Rb-Cs-lab/coil-servo/docs/register_map.md

# Register map (implemented in `cores/coil_servo_top.v`)

Single source of truth for CFG/STS field layout.
`model/coil_servo_model/registers.py` mirrors this file (the integration
testbench and the host tools both use it); the HDL slices in
`coil_servo_top.v` follow this table. **Never invent offsets — change this
file first**, then registers.py, then the HDL (the integration bench catches
disagreement between the last two).

Number formats (`s14`, `Q1.13`, "counts", two's complement) are defined in
the "How to read this document" paragraph of [design.md](design.md).
"Board frame" = signed values as physically measured at the connectors;
"drive frame" = after multiplying by the bridge polarity sign so the loop
always sees positive plant gain (design.md Node B).

## Addressing

One `axi_hub` block connects the FPGA registers to the board's Linux
(and, through the on-board server, to Python on the lab PC) at physical
address **0x4000_0000**. Address bits [27:24] select the hub port; bits
[23:2] select a 32-bit word within it.

| Port | Base | Contents |
|---|---|---|
| 0 | 0x4000_0000 | CFG — the servo's settings, one parameter per 32-bit word (readable back; the host also keeps a local copy) |
| 1 | 0x4100_0000 | STS — live status, read-only |
| 2 | 0x4200_0000 | capture FIFO — **each read pops one word destructively**; drain it only via `Board.capture()` |
| 4 | 0x4400_0000 | XADC readout (the Zynq chip's built-in slow ADC that digitizes the E2 pins: AIN0 coil temperature, AIN1 rail voltage). No host tool reads this yet; code→physical calibration TBD |

One word per parameter (CFG_DATA_WIDTH = 1024, i.e. 32 words — raised
from 512 in MVP rewrite step 3 when words 16–19 were added;
STS_DATA_WIDTH = 256):
wasteful of hub width, trivial to read in a debugger, immune to
straddled-field read/write tearing. All multi-bit fields LSB-aligned in
their word; unused high bits read/write as 0.

## CFG (0x4000_0000 + 4·word)

| Word | Name | Format | Reset | Meaning |
|---|---|---|---|---|
| 0 | `ctrl` | bits | 0 | b0 `servo_enable` (1→0 triggers a graceful ramp-to-zero stop, never an instant bridge drop); b1 `int_clear` (level; pulse from host); b2 `sp_source` (0 = IN2 analog, 1 = `setpoint` reg); b3 `fifo_rst`; b4 `out2_invert`; b5 `boost_mode` (0 = manual, 1 = auto); b6 `boost_manual`; b7 `flip_fault_ack`; b15:8 `led`; b16 `open_loop` (setpoint drives the output stage directly for hardware-in-the-loop ("HIL") transfer-function measurement — clamp/mux/bridge gating still apply; since rev 4 the PI integrator is held cleared while it is set, so switching back to closed loop never applies a wound-up integrator); b17 `capture_sel` (FIFO source: 0 = raw ADC @ 125 MS/s, 131 µs window; 1 = decimated `{error[21:6], measured[21:6]}` per PI tick, 16.8 ms window); b18 `out2_enable` (0 = OUT2 held at exactly 0 V whatever the PI asks for — the MVP has no active clamp; 1 = full-architecture OUT1/OUT2 handoff. Also selects the PI's lower bound: 0 → the floor of word 16, 1 → −`out_clamp`); b19 `trip_ack` (level; pulse from host: leaves TRIPPED for IDLE — re-arming then needs a fresh DIO4 edge); b20 `dither_enable` (1 = OUT1 sigma-delta dither in closed loop: the DAC toggles ±1 count every clock so its average carries the 7 bits of PI output that rounding would drop — ~0.12 A → ~1 mA effective step on the MOT; never exceeds `out_clamp`; MOT: 1. Reset 0 = off); b21 `snap_enable` (rev 5, **zero-setpoint snap**: in RUN, closed loop, when the selected setpoint averaged over one PI tick is within `snap_thresh` (word 23) of zero, OUT1 is forced to exactly 0 at once and the PI integrator is held cleared, so the coil freewheels to zero at its natural rate (bridge stays closed) instead of the PI winding OUT1 down (bench 2026-11-12: ≈ 1.3 ms tail at 2 A). When the setpoint leaves zero the integrator restarts from the RUN floor, exactly like a step from rest. **Also during the board's own forced zero** (build 2026-11-13 onwards, same bit): while the FSM brings the setpoint to zero itself for a flip or a stop (ramp-down, dead time, settle, timeout hold) with the bridge closed, OUT1 is held at 0 the same way, so those ramp-downs run at the freewheel rate whatever the requested setpoint is (bench test 3e: without it a ~0.4 A plateau of 150-250 us remained when the flip request came before the setpoint sign change). Reset 0 = off: OUT1 follows the PI as in rev 4) |
| 1 | `setpoint` | s14 Q1.13 | 0 | register setpoint (counts of I_FS) |
| 2 | `kp_mant` | s18 | 0 | P gain mantissa |
| 3 | `kp_shift` | u5 | 0 | P gain right-shift |
| 4 | `ki_mant` | s18 | 0 | I gain mantissa (per-tick) |
| 5 | `ki_shift` | u6 | 0 | I accumulator right-shift |
| 6 | `out_clamp` | u14 Q1.13 | 0 | hard output clamp, counts — an upper bound on the OUT1 *command* (MVP: calibrate from the measured G_pass; it is not by itself a current limit — word 17 is). Reset 0 ⇒ outputs forced 0 until configured — safe. The host `Board` class additionally refuses to write a value above rated unless constructed with `max_clamp=None` (a typo rail; the fabric clamp is the real enforcement). |
| 7 | `deadband` | u14 Q1.13 | 0 | OUT1/OUT2 handoff deadband |
| 8 | `zero_win` | u14 Q1.13 | 0 | flip zero-current window (counts) — PROVISIONAL. Also the setpoint snap window of the slew limiter (word 20) |
| 9 | `zero_holdoff` | u16 | 0 | decimated samples the window must hold |
| 10 | `deadtime` | u16 | 125 | bridge dead time, 8 ns ticks (125 = 1 µs) — PROVISIONAL |
| 11 | `settle` | u32 | 0 | post-flip settle, 8 ns ticks — eddy placeholder, PROVISIONAL |
| 12 | `flip_timeout` | u32 | 0 | RAMP_DOWN timeout, 8 ns ticks. 0 = disabled — but on a real coil always set it nonzero: it is the safety net that parks a flip that can't reach zero current in TIMEOUT_HOLD instead of waiting forever |
| 13 | `dio_invert` | bits | 0 | invert sense of E1 *inputs*: b0 flip request (DIO3), b1 arm (DIO4), b2 fault (DIO5). Reset 0 = as listed in the port table. Output polarities are fixed in HDL on purpose (reset state must be safe unconfigured). |
| 14 | — | u12 | 0 | reserved for `aout0_trim` (transducer offset trim via slow PWM output; wired up in session 7 when it can be validated against a voltmeter) |
| 15 | `slew_up` | u16 | 0 | setpoint slew-rate limit **away from zero** (\|setpoint\| growing), in 2<sup>−14</sup> counts per 8 ns clock (= 2<sup>−7</sup> counts per PI tick). MOT: 200 A/ms → **1074** at I_FS = 200 A (`slew_rate_code()` in fixed_point.py). Applies to IN2 and the `setpoint` register in closed loop; bypassed in `open_loop`; an FSM-forced zero (IDLE, ramp-down, flip, trip) drops the setpoint to 0 at once and it ramps up from 0 afterwards. Reset 0 = the setpoint cannot move (servo does nothing until configured — fail-safe). Why: large steps overshoot/undershoot on the MVP plant (mvp_architecture.md 3.1). |
| 16 | `u_floor` | u14 Q1.13 | 0 | PI lower bound **in RUN only** (MVP, `out2_enable` = 0): the PI output and integrator never go below this many OUT1 counts, so OUT1 rests just below the pass-bank dead zone instead of at 0. Set to ~90 % of the *measured* dead zone (mvp_architecture.md 3.1). Outside RUN the lower bound is 0. Must be < `out_clamp` (the clamp wins if not). Reset 0 = plain zero floor. |
| 17 | `trip_level` | u14 Q1.13 | 0 | over-current trip level, counts **of the IN1 sensor scale** (1 count = I_FS/8192, 24.4 mA at I_FS = 200 A). Trips when \|measured current\| > level for `trip_ticks` consecutive PI ticks, in every state except IDLE. Reset 0 = trips on the first nonzero reading — the servo cannot run until this is configured (fail-safe). MOT: 100 A. |
| 18 | `trip_ticks` | u16 | 0 | consecutive decimated samples (1.024 µs each) above `trip_level` before tripping; 0 and 1 both mean "first sample". |
| 19 | `trip_timeout` | u32 | 0 | after a trip, the longest the bridge stays closed (OUT1 = 0, coil freewheeling) waiting for the current to fall inside `zero_win`, in 8 ns ticks. Then the bridge opens regardless (e.g. a shorted pass FET keeps current flowing). 0 = open the bridge at once (pushes the coil energy into the supply; mvp_architecture.md 3.3). MOT: ~3 ms, comfortably above the 1.3 ms freewheel from 100 A. |
| 20 | `slew_down` | u16 | 0 | setpoint slew-rate limit **toward zero**, same units as word 15. MOT: 50 A/ms → **268**. A move across zero uses this rate down to 0, then `slew_up`. **Snap:** a target inside the zero window (\|target\| < `zero_win`, word 8) is taken at once, unlimited — so stepping the setpoint to zero is a full-speed snap-off (the coil freewheels, ~1.3 ms from 100 A); the down-limit exists to prevent undershoot, which cannot happen at a zero target (decided 2026-11-10). **Bench 2026-11-12:** in practice the PI winds OUT1 down rather than dropping it, so the current falls at the freewheel rate only down to a few tenths of an amp and then tails (2 A: 2 % only after ≈ 1.3 ms); rev 5 adds the zero-setpoint snap (ctrl b21, word 23), which removes it. |
| 21 | `in1_offset` | s14 Q1.13 | 0 | **IN1 zero offset**, counts: subtracted (saturating to s14) from every IN1 sample before the loop, the over-current trip, the zero window, STS `i_meas` and the decimated capture see it. Measure it with `python -m coil_servo_host.zero <channel>` (servo stopped, no current; it records the *raw* ADC codes) and store it as `in1_offset_amps` in channels.toml. **Characterise every new LEM / sensor chain** — a magnetised LEM read ≈ −5.8 A at zero on 11-11. Rev 4. |
| 22 | `in2_offset` | s14 Q1.13 | 0 | **IN2 zero offset** (the analog setpoint input), counts, subtracted the same way; measured by the same tool with the control computer's output at 0 V. Rev 4. |
| 23 | `snap_thresh` | u14 Q1.13 | 0 | zero-setpoint snap threshold (ctrl b21), counts of the setpoint scale: the snap engages when \|tick-averaged setpoint\| ≤ `snap_thresh` and releases when it exceeds `snap_thresh` + 1 (one count of hysteresis). 0 = only an exactly-zero setpoint (the `setpoint` register path); the analog IN2 path needs a few counts for its noise. Must stay well below `zero_win` — any setpoint inside it can no longer be held. The tick average (128 samples) keeps per-sample IN2 noise from toggling the snap. Rev 5. |
| 24–31 | — | | 0 | reserved |

## STS (0x4100_0000 + 4·word)

Signed fields are raw (LSB-aligned, upper bits zero): the host sign-extends
from the stated width (`registers.parse_sts` does this).

| Word | Name | Format | Meaning |
|---|---|---|---|
| 0 | `flags` | bits | b3:0 `fsm_state`; b4 `fault` (DIO5, read-only, no clear path); b5 `bridge_en`; b6 `polarity`; b7 `armed` (DIO4); b8 `out_sat` (hard clamp ±`out_clamp` engaged); b9 `int_railed`; b10 `sp_sign_mismatch`; b11 `timeout_hold`; b12 `u_floor` (PI output sits on its lower bound — in the MVP: OUT1 at the floor, current can only decay); b13 `tripped` (FSM in TRIP or TRIPPED); b14 `snapped` (rev 5: the zero-setpoint snap holds OUT1 at 0 -- on a zero requested setpoint in RUN, or during a flip/stop ramp-down with the bridge closed — `u14` (word 3) then shows the PI output, not the DAC); b31:24 `map_rev` = **5**, the register-map revision (constant in the bitstream; the host refuses CFG writes to any other revision — the 2026-08-27 full-architecture bitstream reads 0, and its 16-word CFG block would alias words 16–20 onto words 0–4; rev 3 = the 11-11 MVP build without offsets / build ID; rev 4 = offsets + build ID; rev 5 = zero-setpoint snap, CFG ctrl b21 / word 23, STS b14) |
| 1 | `i_meas` | s22 Q2.20 | decimated measured current (board frame) |
| 2 | `sp_active` | s14 | setpoint after mux and slew limiter (what the loop sees) |
| 3 | `u14` | s14 | PI output after the hard clamp |
| 4 | `heartbeat` | u32 | free-running counter (liveness readback) |
| 5 | `fifo_count` | u32 | ADC capture FIFO fill (added at the block-design level) |
| 6 | `build_id` | u32 | **firmware build ID**: bits 27:0 = the first 7 hex digits of the git commit the bitstream was built from, bit 28 = built from a work tree with uncommitted changes; 0 = unknown. Stamped in by `projects/coil_servo/block_design.tcl` at build time; `check`, `deploy` and the dashboard print it (`registers.build_id_text`). Rev 4. |
| 7 | — | | reserved |

## FSM state encoding (`flags[3:0]`)

0 IDLE/RUN-disarmed · 1 RUN · 2 RAMP_DOWN · 3 DISABLE · 4 FLIP ·
5 ENABLE · 6 SETTLE · 7 TIMEOUT_HOLD (needs `flip_fault_ack`) ·
8 TRIP (over-current: OUT1 = 0, bridge still closed, current decaying) ·
9 TRIPPED (bridge open, latched; needs `trip_ack`, then a fresh arm edge)

**Leaving IDLE** needs `servo_enable` = 1 **and a rising edge on the arm
input (DIO4)** while in IDLE. An arm level that is already high when the
bitstream loads, after a graceful stop, or after a trip does not count —
the control computer must drop and re-raise it.

TIMEOUT_HOLD means a flip request never reached the zero-current window
within `flip_timeout` — expected during early tuning if `zero_win` is too
tight. The servo keeps pulling toward zero with the bridge closed; nothing
is broken. To acknowledge and resume from Python:

```python
from coil_servo_host import Board, load_channel
ch = load_channel("mot")
with Board(ch["host"]) as b:
    print(b.sts()["fsm_state_name"])   # -> "TIMEOUT_HOLD"
    b.pulse("flip_fault_ack")          # -> back to RUN
```

### TRIPPED — what happened and how to resume

TRIPPED means the measured current exceeded `trip_level`. The FPGA set
OUT1 to zero at once, let the coil current freewheel down with the bridge
closed, and opened the bridge once the current was inside `zero_win` (or
after `trip_timeout`). It stays there, bridge open, until the host
acknowledges. Find out *why* first (setpoint too high? loop oscillating?
pass bank misbehaving?), then:

```python
with Board(ch["host"]) as b:
    b.pulse("trip_ack")                # TRIPPED -> IDLE
# then the control computer drops and re-raises DIO4 (arm) to run again
```
