Rb-Cs-lab/coil-servo/cores/coil_servo_top.v

`timescale 1 ns / 1 ps

// Coil servo integration top: everything between the ADC stream and the
// DAC stream / E1 pins lives here, in plain Verilog, so the whole signal
// path is verified by the cocotb bench (sim/tb_coil_servo_top.py) before
// Vivado ever sees it. The block design only plumbs this core to the PS,
// axi_hub, ADC/DAC interfaces, capture FIFO, and XADC.
//
// Submodules live in modules/ (scripts/core.tcl packages cores/<name>.v
// together with all of modules/*.v, the upstream pattern for hierarchical
// cores).
//
// CFG/STS field layout: docs/register_map.md is the single source of truth;
// model/coil_servo_model/registers.py mirrors it for the bench and host.

module coil_servo_top #
(
  parameter integer HB_DIV_LOG2 = 16,  // heartbeat at 125 MHz / 2^17 ~ 954 Hz
  // build ID (register_map.md STS W6): bits 27:0 = first 7 hex digits of
  // the git commit, bit 28 = built from a tree with uncommitted changes.
  // Set by projects/coil_servo/block_design.tcl at build time; 0 = unknown.
  parameter integer BUILD_ID = 0
)
(
  input  wire         aclk,
  input  wire         aresetn,

  // ADC stream in: [13:0] IN1 = measured current, [29:16] IN2 = setpoint
  input  wire [31:0]  s_axis_tdata,
  input  wire         s_axis_tvalid,

  // DAC stream out: [13:0] OUT1 = pass bank, [29:16] OUT2 = clamp
  // (OUT2 unused in the MVP: held at 0 while CFG out2_enable = 0)
  output wire [31:0]  m_axis_tdata,
  output wire         m_axis_tvalid,

  // raw ADC monitor stream out (to the capture FIFO)
  output wire [31:0]  m01_axis_tdata,
  output wire         m01_axis_tvalid,

  // registers (axi_hub port 0 / port 1)
  input  wire [1023:0] cfg_data,
  output wire [159:0] sts_data,

  // E1 digital inputs (raw pins, conditioned here)
  input  wire         flip_req_i,   // DIO3_P
  input  wire         arm_i,        // DIO4_P
  input  wire         fault_i,      // DIO5_P (report only, no clear path)

  // E1 digital outputs
  output wire         bridge_polarity_o,  // DIO0_P
  output wire         bridge_enable_o,    // DIO1_P (low = all FETs off)
  output reg          boost_o,            // DIO2_P (unused in the MVP)
  output wire         heartbeat_o,        // DIO6_P
  output wire [31:0]  build_id_o,         // STS word 6 (block design concat)

  output wire [7:0]   led_o,
  output wire         fifo_resetn         // capture FIFO reset (active low)
);

  // ------------------------------------------------------------------
  // CFG fields (docs/register_map.md; word n = cfg_data[32n+31 : 32n])
  // ------------------------------------------------------------------
  wire        servo_enable   = cfg_data[0];
  wire        int_clear_host = cfg_data[1];
  wire        sp_source      = cfg_data[2];
  wire        fifo_rst       = cfg_data[3];
  wire        out2_invert    = cfg_data[4];
  wire        boost_mode     = cfg_data[5];
  wire        boost_manual   = cfg_data[6];
  wire        flip_fault_ack = cfg_data[7];
  assign      led_o          = cfg_data[15:8];
  wire        open_loop      = cfg_data[16];  // route setpoint directly to
                                              // the output stage (HIL TF
                                              // measurement; clamp, mux and
                                              // bridge gating still apply)
  wire        capture_sel    = cfg_data[17];  // FIFO: 0 = raw ADC @125 MS/s,
                                              // 1 = decimated {e, i} pairs
  wire        out2_enable    = cfg_data[18];  // 0 = OUT2 held at 0 (MVP)
  wire        trip_ack       = cfg_data[19];  // TRIPPED -> IDLE
  wire        dither_enable  = cfg_data[20];  // OUT1 sigma-delta dither
  wire        snap_enable    = cfg_data[21];  // zero-setpoint snap (rev 5)
  wire signed [13:0] sp_reg       = cfg_data[45:32];    // W1
  wire signed [17:0] kp_mant      = cfg_data[81:64];    // W2
  wire        [4:0]  kp_shift     = cfg_data[100:96];   // W3
  wire signed [17:0] ki_mant      = cfg_data[145:128];  // W4
  wire        [5:0]  ki_shift     = cfg_data[165:160];  // W5
  wire        [13:0] out_clamp    = cfg_data[205:192];  // W6
  wire        [13:0] deadband     = cfg_data[237:224];  // W7
  wire        [13:0] zero_win     = cfg_data[269:256];  // W8
  wire        [15:0] zero_holdoff = cfg_data[303:288];  // W9
  wire        [15:0] deadtime     = cfg_data[335:320];  // W10
  wire        [31:0] settle       = cfg_data[383:352];  // W11
  wire        [31:0] flip_timeout = cfg_data[415:384];  // W12
  wire        [2:0]  dio_invert   = cfg_data[418:416];  // W13
  wire        [15:0] slew_up      = cfg_data[495:480];  // W15
  wire        [13:0] u_floor      = cfg_data[525:512];  // W16
  wire        [13:0] trip_level   = cfg_data[557:544];  // W17
  wire        [15:0] trip_ticks   = cfg_data[591:576];  // W18
  wire        [31:0] trip_timeout = cfg_data[639:608];  // W19
  wire        [15:0] slew_down    = cfg_data[655:640];  // W20
  wire signed [13:0] in1_offset   = cfg_data[685:672];  // W21
  wire signed [13:0] in2_offset   = cfg_data[717:704];  // W22
  wire        [13:0] snap_thresh  = cfg_data[749:736];  // W23

  assign fifo_resetn = aresetn & ~fifo_rst;

  // ------------------------------------------------------------------
  // E1 input conditioning: 2FF synchronizer, programmable inversion,
  // rising-edge pulse for the flip request
  // ------------------------------------------------------------------
  reg [2:0] dio_meta, dio_sync;
  reg       flip_prev;
  always @(posedge aclk) begin
    dio_meta <= {fault_i, arm_i, flip_req_i};
    dio_sync <= dio_meta ^ dio_invert;
    flip_prev <= dio_sync[0];
  end
  wire flip_pulse = dio_sync[0] & ~flip_prev;
  wire armed = dio_sync[1];
  wire fault = dio_sync[2];

  // ------------------------------------------------------------------
  // ADC unpack + monitor passthrough
  // ------------------------------------------------------------------
  // Offset correction (W21/W22): every IN1/IN2 sample has its measured
  // zero offset subtracted (saturating to s14) before the loop, the trip,
  // the zero window, STS and the decimated capture see it. The raw capture
  // (capture_sel = 0) keeps the uncorrected ADC codes -- that is what the
  // zero calibration measures (host coil_servo_host.zero).
  wire signed [13:0] meas_raw = s_axis_tdata[13:0];
  wire signed [13:0] in2_raw  = s_axis_tdata[29:16];
  wire signed [14:0] meas_d   = meas_raw - in1_offset;
  wire signed [14:0] in2_d    = in2_raw - in2_offset;
  reg  signed [13:0] meas_code, in2_code;
  always @(posedge aclk) begin
    meas_code <= (meas_d > 15'sd8191)  ? 14'sd8191 :
                 (meas_d < -15'sd8192) ? -14'sd8192 : meas_d[13:0];
    in2_code  <= (in2_d > 15'sd8191)   ? 14'sd8191 :
                 (in2_d < -15'sd8192)  ? -14'sd8192 : in2_d[13:0];
  end

  // capture source: raw ADC every fast sample, or decimated
  // {error[21:6], measured[21:6]} once per PI tick (16.8 ms per 16384-deep
  // FIFO fill -- long enough to see the 100 Hz plant pole)
  assign m01_axis_tdata  = capture_sel ? {e_dec[21:6], i_dec[21:6]}
                                       : s_axis_tdata;
  assign m01_axis_tvalid = capture_sel ? tick_i : s_axis_tvalid;

  // ------------------------------------------------------------------
  // Error path -> decimators (error and measured current run in lockstep)
  // ------------------------------------------------------------------
  wire sp_force_zero, polarity;
  wire signed [14:0] e_fast;
  wire signed [13:0] sp_active;
  wire sp_sign_mismatch;

  // setpoint slew limiter between the source mux and the error path
  // (servo_slew.v); servo_error then always takes the limited value
  wire signed [13:0] sp_sel = sp_source ? sp_reg : in2_code;
  wire signed [13:0] sp_lim;

  servo_slew slew_0 (
    .aclk(aclk), .aresetn(aresetn),
    .target(sp_sel), .hold_zero(sp_force_zero), .bypass(open_loop),
    .rate_up(slew_up), .rate_down(slew_down), .snap_win(zero_win),
    .sp_out(sp_lim)
  );

  servo_error err_0 (
    .aclk(aclk), .aresetn(aresetn),
    .meas(meas_code), .in2(in2_code), .sp_reg(sp_lim),
    .sp_source(1'b1), .sp_force_zero(sp_force_zero),
    .polarity(polarity),
    .e_fast(e_fast), .sp_active(sp_active),
    .sp_sign_mismatch(sp_sign_mismatch)
  );

  // The offset-correction register and servo_error each add one clock:
  // delay valid by two and the corrected meas by one so both decimators see
  // sample-aligned inputs
  reg valid_q, valid_r;
  reg signed [14:0] meas_r;
  always @(posedge aclk) begin
    valid_q <= aresetn & s_axis_tvalid;
    valid_r <= aresetn & valid_q;
    meas_r <= meas_code;
  end

  wire signed [21:0] e_dec, i_dec;
  wire tick_e, tick_i;

  servo_decimator dec_e (
    .aclk(aclk), .aresetn(aresetn),
    .in_valid(valid_r), .e_fast(e_fast),
    .e_out(e_dec), .out_valid(tick_e)
  );

  servo_decimator dec_i (
    .aclk(aclk), .aresetn(aresetn),
    .in_valid(valid_r), .e_fast(meas_r),
    .e_out(i_dec), .out_valid(tick_i)
  );

  // ------------------------------------------------------------------
  // Flip FSM
  // ------------------------------------------------------------------
  wire bridge_en, fsm_int_clear, int_hold, out_kill, run_state;
  wire [3:0] fsm_state;
  wire timeout_hold, tripped;

  servo_flip_fsm fsm_0 (
    .aclk(aclk), .aresetn(aresetn),
    .servo_enable(servo_enable), .armed(armed),
    .flip_req(flip_pulse), .flip_fault_ack(flip_fault_ack),
    .trip_ack(trip_ack),
    .tick(tick_i), .i_meas(i_dec),
    .zero_win(zero_win), .zero_holdoff(zero_holdoff),
    .deadtime(deadtime), .settle(settle), .flip_timeout(flip_timeout),
    .trip_level(trip_level), .trip_ticks(trip_ticks),
    .trip_timeout(trip_timeout),
    .bridge_en(bridge_en), .polarity(polarity),
    .sp_force_zero(sp_force_zero), .int_clear(fsm_int_clear),
    .int_hold(int_hold), .out_kill(out_kill), .run_state(run_state),
    .fsm_state(fsm_state), .timeout_hold(timeout_hold), .tripped(tripped)
  );

  assign bridge_polarity_o = polarity;
  assign bridge_enable_o = bridge_en;

  // ------------------------------------------------------------------
  // Zero-setpoint snap (rev 5; register_map.md ctrl b21, W23, STS b14).
  // In RUN, closed loop: when the selected setpoint, averaged over one PI
  // tick, is within snap_thresh of zero, OUT1 is forced to exactly 0 and
  // the integrator is held cleared. The bank turns fully off at once and
  // the coil freewheels at its natural rate with the bridge closed --
  // instead of the PI winding OUT1 down through the bank's turn-on region
  // (bench 2026-11-12: a ~1.3 ms tail at 2 A). When the setpoint leaves
  // zero, the integrator restarts from the RUN floor (its anti-windup
  // bound), the same as a step from rest. The tick average keeps per-sample
  // IN2 noise from toggling the snap; one count of hysteresis keeps a
  // setpoint sitting on the threshold from chattering.
  // ------------------------------------------------------------------
  wire signed [21:0] sp_dec;
  wire tick_s;
  servo_decimator dec_s (
    .aclk(aclk), .aresetn(aresetn),
    .in_valid(valid_q), .e_fast({sp_sel[13], sp_sel}),
    .e_out(sp_dec), .out_valid(tick_s)
  );
  // |sp_dec| <= 2^20 (s14 x 128), so the negation cannot overflow
  wire [21:0] abs_sp_dec = sp_dec[21] ? -sp_dec : sp_dec;
  wire [21:0] snap_on_lim  = {1'b0, snap_thresh, 7'd0};
  wire [21:0] snap_off_lim = {1'b0, snap_thresh, 7'd0} + 22'd128;
  reg snap_zero;
  always @(posedge aclk)
    if (!aresetn || !snap_enable || !run_state || open_loop)
      snap_zero <= 1'b0;
    else if (tick_s)
      snap_zero <= snap_zero ? (abs_sp_dec <= snap_off_lim)
                             : (abs_sp_dec <= snap_on_lim);

  // ------------------------------------------------------------------
  // PI and output stage
  // ------------------------------------------------------------------
  wire signed [13:0] u14;
  wire out_sat, int_railed, at_floor;
  wire signed [6:0] pi_resid;
  wire signed [47:0] acc_mon;

  // PI lower bound (register map W16 and ctrl b18): full architecture ->
  // symmetric -out_clamp (OUT2 side); MVP -> u_floor in RUN, 0 otherwise.
  // u_floor >= 8192 saturates to 8191 (and then the clamp wins in servo_pi).
  // Registered: CFG and FSM state change rarely against the 128-clock tick.
  wire signed [13:0] u_floor_s = u_floor[13] ? 14'sd8191 : u_floor;
  reg  signed [13:0] pi_floor;
  always @(posedge aclk)
    pi_floor <= !aresetn   ? 14'sd0 :
                out2_enable ? -$signed(out_clamp) :
                run_state   ? u_floor_s : 14'sd0;

  servo_pi pi_0 (
    .aclk(aclk), .aresetn(aresetn),
    .tick(tick_e), .e(e_dec),
    .kp_mant(kp_mant), .kp_shift(kp_shift),
    .ki_mant(ki_mant), .ki_shift(ki_shift),
    .clamp(out_clamp), .floor(pi_floor),
    // open loop holds the integrator cleared: it would otherwise wind up
    // against an error the open-loop drive does not correct, and hit OUT1
    // on the switch back to closed loop (loopback 2026-11-11)
    .int_hold(int_hold),
    .int_clear(fsm_int_clear | int_clear_host | open_loop | snap_zero),
    .u14(u14), .out_sat(out_sat), .at_floor(at_floor), .resid(pi_resid),
    .acc_mon(acc_mon),
    .int_railed(int_railed)
  );

  // open-loop mode (HIL transfer-function measurement): the setpoint --
  // IN2 from a lab function generator, or the register -- drives the output
  // stage directly. The hard clamp, the deadband mux, and the bridge-enable
  // gate all still apply; the loop is open, the safety is not.
  wire signed [13:0] clamp_pos_ol = out_clamp[13:0];
  wire signed [13:0] sp_clamped =
      (sp_active > clamp_pos_ol)  ? clamp_pos_ol :
      (sp_active < -clamp_pos_ol) ? -clamp_pos_ol : sp_active;
  // Registered: the CFG-regs -> clamp compare -> source select -> output
  // mux chain fails 125 MHz timing as one combinational cone (measured
  // -2 ns on the first hardware build). One pipeline flop here splits it;
  // the extra 8 ns is nothing against the 128-cycle PI tick.
  // OUT1 resolution dither (servo_dither.v): closed loop only
  wire signed [13:0] u_dith;
  servo_dither dith_0 (
    .aclk(aclk), .aresetn(aresetn),
    .enable(dither_enable & ~open_loop),
    .u14(u14), .resid(pi_resid), .lo(pi_floor), .clamp(out_clamp),
    .u_out(u_dith)
  );

  reg signed [13:0] u_drive;
  always @(posedge aclk)
    u_drive <= (!aresetn || snap_zero) ? 14'sd0 :
               (open_loop ? sp_clamped : u_dith);

  wire signed [13:0] out1, out2;

  servo_output_mux mux_0 (
    .aclk(aclk), .aresetn(aresetn),
    // outputs live only with the bridge closed and no over-current trip
    .enable(bridge_en & ~out_kill),
    .u14(u_drive), .deadband(deadband), .out2_invert(out2_invert),
    .out2_enable(out2_enable),
    .out1(out1), .out2(out2)
  );

  assign m_axis_tdata = {2'b00, out2, 2'b00, out1};
  assign m_axis_tvalid = 1'b1;

  // ------------------------------------------------------------------
  // Boost cap (DIO2): manual bit, or auto = from the FSM's integrator-clear
  // (arming / post-flip re-enable) until |I| first reaches ~87.5% of the
  // setpoint. Gated off while the setpoint is forced to zero.
  // ------------------------------------------------------------------
  reg auto_boost;
  wire [21:0] abs_i  = i_dec[21] ? -i_dec : i_dec;
  wire signed [21:0] sp20 = {sp_active, 7'b0000000};
  wire [21:0] abs_sp = sp20[21] ? -sp20 : sp20;
  wire [21:0] boost_thresh = abs_sp - (abs_sp >> 3);

  always @(posedge aclk) begin
    if (!aresetn)
      auto_boost <= 1'b0;
    else if (fsm_int_clear)
      auto_boost <= 1'b1;
    else if (!sp_force_zero && tick_i && (abs_i >= boost_thresh))
      auto_boost <= 1'b0;
    boost_o <= aresetn & (boost_mode ? (auto_boost & ~sp_force_zero)
                                     : boost_manual);
  end

  // ------------------------------------------------------------------
  // Heartbeat: depends on nothing but the clock
  // ------------------------------------------------------------------
  wire [31:0] hb_cnt;
  servo_heartbeat #(.DIV_LOG2(HB_DIV_LOG2)) hb_0 (
    .aclk(aclk), .heartbeat(heartbeat_o), .cnt_mon(hb_cnt)
  );

  // ------------------------------------------------------------------
  // STS assembly (words 0-4; word 5 = FIFO count is added in the block
  // design; words 6-7 reserved)
  // ------------------------------------------------------------------
  assign sts_data[3:0]     = fsm_state;
  assign sts_data[4]       = fault;
  assign sts_data[5]       = bridge_en;
  assign sts_data[6]       = polarity;
  assign sts_data[7]       = armed;
  assign sts_data[8]       = out_sat;
  assign sts_data[9]       = int_railed;
  assign sts_data[10]      = sp_sign_mismatch;
  assign sts_data[11]      = timeout_hold;
  assign sts_data[12]      = at_floor;
  assign sts_data[13]      = tripped;
  assign sts_data[14]      = snap_zero;
  assign sts_data[23:15]   = 9'd0;
  // register-map revision (docs/register_map.md; registers.MAP_REV): the
  // host refuses to write CFG to a bitstream whose layout it doesn't know
  assign sts_data[31:24]   = 8'd5;
  assign sts_data[53:32]   = i_dec;          // W1, s22 (host sign-extends)
  assign sts_data[63:54]   = 10'd0;
  assign sts_data[77:64]   = sp_active;      // W2, s14 (host sign-extends)
  assign sts_data[95:78]   = 18'd0;
  assign sts_data[109:96]  = u14;            // W3, s14 (host sign-extends)
  assign sts_data[127:110] = 18'd0;
  assign sts_data[159:128] = hb_cnt;         // W4

  assign build_id_o = BUILD_ID;

endmodule
