Rb-Cs-lab/coil-servo/host/coil_servo_host/config.py

"""Load host/config/channels.toml, build the physics model from it, and
convert physical units into register values (amps -> counts, us -> 8 ns
ticks, A/ms -> slew codes, float gains -> mantissa + shift).

    python -m coil_servo_host.config mot     # print what gets derived

The physics block of each channel overrides the defaults in
model/coil_servo_model/channels.py; I_FS, the OUT1 command clamp and the
dead-zone floor are DERIVED from that model (so a new bench measurement in
channels.toml flows straight into the registers), unless overridden by a
directly measured value (out_clamp_counts, u_floor_counts).

mot_bench is the MOT channel's low-current test profile (bench supply with a
current limit, LEM wound N times; docs/bench_supply_test.md). Its supply
limit I_supply_max adds checks: rated current and trip level below it.
"""

import argparse
import tomllib
from dataclasses import replace
from pathlib import Path

from coil_servo_model.channels import BENCH_CHANNELS, CHANNELS, Channel
from coil_servo_model.fixed_point import decode_gain, encode_gain, slew_rate_code
from coil_servo_model.loop import T_S

CONFIG_PATH = Path(__file__).resolve().parents[1] / "config" / "channels.toml"
TICK_NS = 8.0

# CFG `led` byte (ctrl b15:8) written with every configuration: LED 7 lit =
# bench settings loaded, all LEDs off = production settings.
BENCH_LED_INDEX = 7
BENCH_LED = 1 << BENCH_LED_INDEX

# CFG fields compared to tell which channels.toml profile a board holds
PROFILE_MATCH_KEYS = ("trip_level", "out_clamp", "zero_win", "led",
                      "kp_mant", "kp_shift", "ki_mant", "ki_shift")

# fixed requirement (CLAUDE.md): MOT rail <= 6 V, shim rails <= 10 V.
# mot_bench is the MOT coil on a bench supply: same limit.
RAIL_LIMIT = {"mot": 6.0, "mot_bench": 6.0}
RAIL_LIMIT_DEFAULT = 10.0

# channels.toml keys that override model Channel fields
PHYSICS_KEYS = ("I_rated", "V_rail", "V_th", "g_fs", "gain_opamp",
                "out1_terminated", "out1_fs_volts", "out1_offset_volts",
                "V_opamp_max", "R_burden", "G_inamp", "lem_turns",
                "I_supply_max", "in1_fs_volts")


def amps_to_counts(amps: float, i_fs: float) -> int:
    """Amps -> counts of the IN1 sensor scale (1 count = I_FS/8192)."""
    return round(amps / i_fs * 8192)


def counts_to_amps(counts: float, i_fs: float) -> float:
    """s14 counts of the sensor scale (sp_active, setpoint) -> amps."""
    return counts * i_fs / 8192


def i_meas_amps(i_meas: int, i_fs: float) -> float:
    """STS i_meas (decimated s22: 128 x the mean IN1 code) -> amps."""
    return i_meas / 128 * i_fs / 8192


def out1_volts(u14: int, model: Channel) -> float:
    """PI output u14 (OUT1 DAC counts) -> volts at the op-amp input (1 V
    full scale into 50 ohm, about 2 V unterminated)."""
    return u14 / 8192 * model.out1_factor + model.out1_offset_volts


def channel_names(path: Path = CONFIG_PATH) -> list:
    """Channel names in channels.toml, in file order."""
    with open(path, "rb") as f:
        return [n for n, t in tomllib.load(f).items() if isinstance(t, dict)]


def channel_table(name: str, path: Path = CONFIG_PATH) -> dict:
    """The raw channels.toml table of one channel (keys the loader does not
    know are kept)."""
    with open(path, "rb") as f:
        return tomllib.load(f)[name]


def build_model(name: str, table: dict) -> Channel:
    """The model Channel for this channel, with channels.toml's physics."""
    base = (CHANNELS.get(name) or BENCH_CHANNELS.get(name)
            or Channel(name=name, L=16e-6, R_coil=6.4e-3,
                       I_rated=float(table["I_rated"])))
    over = {k: table[k] for k in PHYSICS_KEYS if k in table}
    if "V_th" in over:
        over["V_th"] = tuple(float(v) for v in over["V_th"])
    for k in ("I_rated", "V_rail", "g_fs", "gain_opamp", "R_burden", "G_inamp",
              "I_supply_max", "out1_fs_volts", "out1_offset_volts",
              "V_opamp_max", "in1_fs_volts"):
        if k in over:
            over[k] = float(over[k])
    if "out1_terminated" in over:
        over["out1_terminated"] = bool(over["out1_terminated"])
    if "lem_turns" in over:
        n = over["lem_turns"]
        if isinstance(n, bool) or not isinstance(n, int) or n < 1:
            raise ValueError(f"[{name}] lem_turns = {n!r} must be a whole "
                             f"number of turns >= 1")
    # the clamp override lives in this file only: without the key the clamp
    # is derived from the model (I_rated), whatever the model's default
    over["out_clamp_counts"] = (int(table["out_clamp_counts"])
                                if "out_clamp_counts" in table else None)
    return replace(base, name=name, **over)


def load_channel(name: str, path: Path = CONFIG_PATH) -> dict:
    """Returns {"name", "host", "i_fs", "i_rated", "bench", "model", "cfg"}.

    cfg is ready for Board.apply_config(); it does NOT include
    servo_enable -- enabling is always an explicit, separate call.
    """
    with open(path, "rb") as f:
        table = tomllib.load(f)[name]

    model = build_model(name, table)
    i_fs = model.I_FS
    i_rated = model.I_rated

    # --- sanity rails on values that would silently defeat safety ---
    def refuse(msg):
        raise ValueError(f"[{name}] {msg}")

    rail_max = RAIL_LIMIT.get(name, RAIL_LIMIT_DEFAULT)
    if not 0 < model.V_rail <= rail_max:
        refuse(f"V_rail = {model.V_rail} V is outside 0 .. {rail_max} V "
               f"(fixed limit for this coil)")
    if not 0 < i_rated < i_fs:
        refuse(f"needs 0 < I_rated < I_FS (I_rated={i_rated}, I_FS={i_fs:g}: "
               f"rated current must be measurable on IN1)")
    trip_amps = float(table["trip_amps"])
    if not 0 < trip_amps < i_fs:
        refuse(f"trip_amps = {trip_amps} must be inside 0 .. I_FS = {i_fs:g} A")
    i_sup = model.I_supply_max
    bench = table.get("bench", False)
    if not isinstance(bench, bool):
        refuse(f"bench = {bench!r} must be true or false")
    if bench != (i_sup is not None):
        refuse("bench = true and I_supply_max go together: a bench profile "
               "names its supply's current limit, and only a bench profile "
               "has one")
    if i_sup is not None:
        # current-limited (bench) supply: its CC limit is the hard limit, and
        # the firmware trip must sit below it -- otherwise the supply holds
        # the current at its limit, the trip never fires, and the PI winds up
        # to the clamp (slow recovery). Rated must sit below both.
        if i_sup <= 0:
            refuse(f"I_supply_max = {i_sup} A must be > 0")
        if not i_rated < i_sup:
            refuse(f"I_rated = {i_rated} A must be below the supply current "
                   f"limit I_supply_max = {i_sup} A")
        if not trip_amps < i_sup:
            refuse(f"trip_amps = {trip_amps} A must be below the supply current "
                   f"limit I_supply_max = {i_sup} A, or the firmware trip can "
                   f"never fire (the supply holds the current at its limit)")
    if float(table["zero_win_amps"]) <= 0:
        refuse("zero_win_amps must be > 0, or a flip can never qualify its "
               "zero-current window")
    if float(table["flip_timeout_us"]) <= 0:
        refuse("flip_timeout_us must be > 0: the timeout is the safety net "
               "that parks an unreachable flip in TIMEOUT_HOLD "
               "(see docs/register_map.md)")
    if float(table["trip_timeout_us"]) < 0:
        refuse("trip_timeout_us must be >= 0")
    for k in ("slew_up_amps_per_ms", "slew_down_amps_per_ms"):
        if float(table[k]) <= 0:
            refuse(f"{k} must be > 0 (0 freezes the setpoint)")
    # zero-setpoint snap (register map rev 5); optional, default off
    snap_en = int(table.get("snap_zero_enable", 0))
    snap_amps = float(table.get("snap_zero_amps", 0.0))
    if snap_en not in (0, 1):
        refuse(f"snap_zero_enable = {snap_en} must be 0 or 1")
    if snap_amps < 0:
        refuse(f"snap_zero_amps = {snap_amps} A must be >= 0")
    if snap_amps >= 0.5 * float(table["zero_win_amps"]):
        refuse(f"snap_zero_amps = {snap_amps} A must stay well below the flip "
               f"zero window ({table['zero_win_amps']} A): every setpoint at or "
               f"below it means 'off', so it could not be held")
    for k in ("out2_enable", "boost_mode"):
        if int(table[k]) != 0:
            refuse(f"{k} must be 0: OUT2 / the boost output are not fitted "
                   f"in the MVP")

    # sensor zero offsets (measured with python -m coil_servo_host.zero),
    # in amps of the sensor scale; optional, default 0
    in1_off = float(table.get("in1_offset_amps", 0.0))
    in2_off = float(table.get("in2_offset_amps", 0.0))
    for k, v in (("in1_offset_amps", in1_off), ("in2_offset_amps", in2_off)):
        if abs(v) > 0.1 * i_fs:
            refuse(f"{k} = {v} A is more than 10 % of the sensor full scale "
                   f"({i_fs:g} A): that is a broken or saturated sensor, not "
                   f"an offset to calibrate away")

    # --- derived register values ---
    out_clamp = model.clamp_counts     # out_clamp_counts if set, else derived
    if "u_floor_counts" in table:
        u_floor = int(table["u_floor_counts"])
    else:
        u_floor = round(float(table["floor_frac"]) * model.dead_zone * 8192)
    if not 0 < out_clamp <= 8191:
        refuse(f"OUT1 clamp {out_clamp} counts outside 1 .. 8191")
    if not 0 <= u_floor < out_clamp:
        refuse(f"floor {u_floor} counts must be below the clamp {out_clamp}")

    kp, ki = loop_gains(table, i_fs, refuse)
    kp_mant, kp_shift = encode_gain(kp, shift_bits=5)
    ki_mant, ki_shift = encode_gain(ki * T_S, shift_bits=6)

    def ticks(us: float) -> int:
        return round(us * 1000.0 / TICK_NS)

    cfg = dict(
        kp_mant=kp_mant, kp_shift=kp_shift,
        ki_mant=ki_mant, ki_shift=ki_shift,
        out_clamp=out_clamp,
        u_floor=u_floor,
        deadband=int(table["deadband_counts"]),
        zero_win=amps_to_counts(float(table["zero_win_amps"]), i_fs),
        zero_holdoff=int(table["zero_holdoff_ticks"]),
        deadtime=ticks(float(table["deadtime_us"])),
        settle=ticks(float(table["settle_us"])),
        flip_timeout=ticks(float(table["flip_timeout_us"])),
        trip_level=amps_to_counts(trip_amps, i_fs),
        trip_ticks=int(table["trip_ticks"]),
        trip_timeout=ticks(float(table["trip_timeout_us"])),
        slew_up=slew_rate_code(float(table["slew_up_amps_per_ms"]) * 1e3, i_fs),
        slew_down=slew_rate_code(float(table["slew_down_amps_per_ms"]) * 1e3, i_fs),
        dio_invert=int(table["dio_invert"]),
        out2_invert=int(table["out2_invert"]),
        out2_enable=int(table["out2_enable"]),
        boost_mode=int(table["boost_mode"]),
        dither_enable=int(table["dither_enable"]),
        snap_enable=snap_en,
        snap_thresh=amps_to_counts(snap_amps, i_fs),
        in1_offset=amps_to_counts(in1_off, i_fs),
        in2_offset=amps_to_counts(in2_off, i_fs),
        # board LEDs: a fixed pattern marks bench settings (0 = production)
        led=BENCH_LED if bench else 0,
    )
    return {"name": name, "host": table["board_host"], "i_fs": i_fs,
            "i_rated": i_rated, "bench": bench, "model": model, "cfg": cfg}


def loop_gains(table: dict, i_fs: float, refuse) -> tuple[float, float]:
    """(kp, ki [1/s]) in normalized units (1.0 = I_FS on the error side,
    full DAC scale on the output side).

    Two ways to write them in channels.toml:
      * kp / ki: normalized -- tied to the sensor scale I_FS;
      * kp_counts_per_amp / ki_counts_per_amp_ms: OUT1 counts per amp of
        error (and per amp-millisecond for the integral). These depend only
        on the pass bank's gain, not on I_FS, so a changed in-amp gain or
        LEM turn count leaves the loop unchanged.
    """
    normalized = "kp" in table or "ki" in table
    physical = "kp_counts_per_amp" in table or "ki_counts_per_amp_ms" in table
    if normalized == physical:
        refuse("give the PI gains either as kp / ki or as kp_counts_per_amp / "
               "ki_counts_per_amp_ms (one pair, not both)")
    if normalized:
        return float(table["kp"]), float(table["ki"])
    kp = float(table["kp_counts_per_amp"]) * i_fs / 8192
    ki = float(table["ki_counts_per_amp_ms"]) * 1e3 * i_fs / 8192
    return kp, ki


def banner(ch: dict) -> str:
    """A loud block for bench profiles ("" for production). Every host tool
    prints it right after loading the channel."""
    if not ch["bench"]:
        return ""
    m = ch["model"]
    lines = [
        f"BENCH PROFILE '{ch['name']}': settings for a CURRENT-LIMITED BENCH",
        f"SUPPLY ({m.I_supply_max:g} A limit). NEVER use with the SE-600-5.",
        f"Board LED {BENCH_LED_INDEX} lit = bench settings loaded.",
        f"In-amp gain G_inamp = {m.G_inamp:g} (I_FS = {m.I_FS:g} A) -- must "
        f"match the board as wired.",
    ]
    w = max(len(s) for s in lines)
    bar = "#" * (w + 6)
    return "\n".join([bar] + [f"## {s:<{w}} ##" for s in lines] + [bar])


def announce(ch: dict) -> None:
    """Print the bench banner, if any (call right after load_channel)."""
    text = banner(ch)
    if text:
        print(text)
        print()


def identify_profile(board_cfg: dict, host: str,
                     path: Path = CONFIG_PATH) -> list[str]:
    """Names of the channels.toml profiles for this board (same board_host)
    whose derived settings the board's CFG matches on PROFILE_MATCH_KEYS.
    Empty = unknown, mixed, or not configured since the bitstream loaded."""
    with open(path, "rb") as f:
        names = [n for n, t in tomllib.load(f).items()
                 if isinstance(t, dict) and t.get("board_host") == host]
    matches = []
    for n in names:
        try:
            cfg = load_channel(n, path)["cfg"]
        except (ValueError, KeyError):
            continue                       # a broken section matches nothing
        if all(board_cfg.get(k) == cfg[k] for k in PROFILE_MATCH_KEYS):
            matches.append(n)
    return matches


def profile_report(board_cfg: dict, ch: dict,
                   path: Path = CONFIG_PATH) -> tuple[bool, str]:
    """(ok, text): which profile the board holds, and a loud warning if it
    is not the one this tool was invoked with."""
    matches = identify_profile(board_cfg, ch["host"], path)
    if ch["name"] in matches:
        return True, f"board holds the '{ch['name']}' settings"
    if matches:
        held = " / ".join(matches)
        return False, (f"*** WARNING: the board holds the '{held}' settings, "
                       f"but this tool was run as '{ch['name']}'. Wrong "
                       f"channel name for the hardware connected? ***")
    return False, ("*** board settings: UNKNOWN / mixed (or not configured "
                   "since the bitstream was loaded) -- they match no profile "
                   f"for {ch['host']} in channels.toml ***")


def summary_rows(ch: dict) -> list:
    """The derived quantities as (label, text) rows -- everything summary()
    prints after its header line. Used by summary() and the dashboard."""
    m, c = ch["model"], ch["cfg"]
    f = m.out1_factor                  # OUT1 volts per normalized unit

    def rate(code):                    # slew code -> A/ms
        return code / 2**14 * m.amps_per_lsb * 125e6 / 1e3

    kp = decode_gain(c["kp_mant"], c["kp_shift"])
    ki = decode_gain(c["ki_mant"], c["ki_shift"]) / T_S

    turns = f", LEM {m.lem_turns} primary turns" if m.lem_turns != 1 else ""
    rows = []
    if m.I_supply_max is not None:
        margin = m.I_supply_max / m.amps_per_lsb - c["trip_level"]
        rows.append((
            "supply limit",
            f"{m.I_supply_max:g} A (current-limited supply: the hard limit; "
            f"the firmware trip sits {margin:.0f} counts = "
            f"{margin * m.amps_per_lsb:.2f} A below it; an IN1 offset more "
            f"negative than that keeps it from firing)"))
    rows += [
        ("sensor scale I_FS", f"{m.I_FS:.4g} A at IN1 full scale "
         f"({m.in1_fs_volts:g} V) "
         f"({m.amps_per_lsb * 1e3:.2f} mA per ADC count{turns})"),
        ("pass bank G_pass", f"{m.G_pass / f:.0f} A per volt at OUT1 "
         f"(OUT1 {'terminated' if m.out1_terminated else 'UNterminated'}; "
         f"plant gain {m.G_pass / m.I_FS:.2f}; one OUT1 count "
         f"~ {m.G_pass / 8192 * 1e3:.0f} mA)"),
        ("dead zone", f"{m.dead_zone * f + m.out1_offset_volts:.3f} V at OUT1 "
         f"({min(m.V_th):.2f} V gate, {m.dead_zone * 8192:.0f} counts)"),
        ("RUN floor", f"{c['u_floor']} counts "
         f"({c['u_floor'] / 8192 * f + m.out1_offset_volts:.3f} V at OUT1)"),
        ("OUT1 command clamp", f"{c['out_clamp']} counts "
         f"({c['out_clamp'] / 8192 * f + m.out1_offset_volts:.3f} V at OUT1; limits the command, "
         f"not the current)"),
        ("over-current trip", f"{c['trip_level'] * m.amps_per_lsb:.4g} A "
         f"({c['trip_level']} counts) for {c['trip_ticks']} samples"),
        ("flip zero window", f"{c['zero_win'] * m.amps_per_lsb:.3g} A "
         f"({c['zero_win']} counts); freewheel from rated "
         f"~ {m.freewheel_time * 1e6:.0f} us"),
        ("setpoint ramps", f"{rate(c['slew_up']):.0f} A/ms up, "
         f"{rate(c['slew_down']):.0f} A/ms down "
         f"(codes {c['slew_up']} / {c['slew_down']})"),
        ("PI gains", f"kp {kp:.4g}, ki {ki:.4g}/s normalized "
         f"(= {kp * 8192 / m.I_FS:.4g} counts/A, "
         f"{ki * 8.192 / m.I_FS:.4g} counts/(A ms))"),
        ("dither", "on" if c["dither_enable"] else "off"),
        ("zero-setpoint snap",
         (f"on: |setpoint| <= {c['snap_thresh'] * m.amps_per_lsb:.3g} A "
          f"({c['snap_thresh']} counts) -> OUT1 = 0 at once, coil freewheels")
         if c["snap_enable"] else "off (OUT1 follows the PI down to zero)"),
        ("IN1 / IN2 zero offset", f"{c['in1_offset'] * m.amps_per_lsb:+.3f} A "
         f"({c['in1_offset']:+d} counts) / "
         f"{c['in2_offset'] * m.amps_per_lsb:+.3f} A "
         f"({c['in2_offset']:+d} counts), subtracted in the FPGA"
         + ("" if c["in1_offset"] else
            " -- IN1 not calibrated: run python -m coil_servo_host.zero")),
        ("board LEDs", f"LED {BENCH_LED_INDEX} lit (bench settings)"
         if c["led"] else "all off (production settings)"),
    ]
    return rows


def summary_header(ch: dict) -> str:
    m = ch["model"]
    return f"channel {m.name}: rail {m.V_rail:g} V, rated {m.I_rated:g} A"


def summary(ch: dict) -> str:
    """Human-readable account of the derived quantities."""
    lines = [summary_header(ch)]
    lines += [f"  {label:<18s} = {text}" for label, text in summary_rows(ch)]
    return "\n".join(lines)


def main():
    p = argparse.ArgumentParser(description=__doc__,
                                formatter_class=argparse.RawDescriptionHelpFormatter)
    p.add_argument("channel")
    args = p.parse_args()
    ch = load_channel(args.channel)
    announce(ch)
    print(summary(ch))


if __name__ == "__main__":
    main()
