Rb-Cs-lab/coil-servo/(commit log)

2026-08-26 Add servo bootstrap prompt
2026-08-26 Strip upstream to bitstream flow only
    Remove pavel-demin's OS half (alpine, debian, dts, patches, kernel/boot
    Makefile targets), 48 of 49 example projects, and unused cores. We run
    the official Red Pitaya OS 3.x on the board, so only the Tcl bitstream
    flow survives: scripts/{core,project,bitstream}.tcl, a curated core
    subset, cfg/ constraints, and projects/playground as a known-good
    block-design reference. Everything removed is recoverable from the
    merged upstream history (tag 20251012).
    [transmit-wspr-message.cfg, write-c2-files.cfg]
2026-08-26 Add CLAUDE.md and coil_servo project stub
    CLAUDE.md pins the verified toolchain (Vivado+Vitis 2025.1 for OS 3.x,
    Ubuntu 24.04 host), the axi_hub register decode at 0x40000000, port
    assignment, plant table, safety invariants, and the open-unknowns rule.
    projects/coil_servo/block_design.tcl is the infrastructure skeleton
    (PS7 + axi_hub + ADC capture + XADC, DAC pinned to zero) wired after the
    proven playground design; servo cores land after their cocotb benches
    pass. Restore axis_fifo/axis_counter/axis_bram_reader so playground
    still builds as a toolchain smoke test.
2026-08-26 Add fixed-point design doc and draft register map
    docs/design.md: full signal path with Q-format and gain-per-LSB at every
    node, decimation ratio 128, the five saturation points, PI word widths,
    anti-windup mechanisms, flip FSM timing, and loop-dynamics sanity check.
    Four decisions flagged for review before HDL: rated = 80% of ADC full
    scale, drive-frame polarity rotation, handoff on sign of PI output
    rather than literal error sign, DIO4/boost-cap semantics.
    docs/register_map.md: draft word-per-parameter CFG/STS layout behind
    axi_hub at 0x40000000; becomes SSOT once the design doc is approved.
2026-08-26 Apply design review: clamp at 100% rated, physicist-oriented docs
    Review decisions folded into docs/design.md: output clamp moved from
    BOOTSTRAP's ~110% to 100% of rated current (runtime register, trivially
    revisited); sign-of-u handoff and bridge-frame polarity rotation
    confirmed; DIO4 arm and boost-cap semantics confirmed. Added dio_invert
    CFG register so E1 input polarities are runtime-configurable; output
    polarities stay build-time on purpose (unconfigured reset state must be
    safe). Register map and CLAUDE.md updated to match.
    README rewritten as the physicist-facing entry point: how the three
    machines fit together, jargon defined, full setup for simulation env /
    Vivado build host / boa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
2026-08-26 Add Python reference model with 29 passing tests
    model/coil_servo_model implements the design.md contract in software:
    channels.py (BOOTSTRAP plant table, every unmeasured value flagged
    provisional), plant.py (RL coil + transconductance pass bank with
    voltage-compliance slew limits + active clamp; clamp transfer
    characteristic flagged as an assumption with a voltage-mode fallback),
    pi.py (float PI, the trusted reference, exact design.md operation
    order), fixed_point.py (bit-exact integer mirror the HDL will be
    compared against, including the boxcar decimator and s18+shift gain
    encoding), loop.py (closed-loop simulator), analysis.py (settling,
    margins, provisional gain suggestions).
    Measured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
    [test_channels.py, test_fixed_point.py]
2026-08-26 Add cocotb bench and first servo cores: decimator and PI, bit-exact
    sim/ runs each core under Icarus Verilog via the cocotb runner (plain
    pytest, no Makefiles -- works on Windows and Linux; conftest finds the
    winget iverilog install). servo_decimator.v and servo_pi.v are compared
    tick-for-tick against the fixed-point Python mirror: output, saturation
    flag, AND integrator state, across three gain sets including the most
    violent representable one, with random hold/clear events and rail
    errors.
    Directed benches assert the BOOTSTRAP requirements at HDL level: reset
    state is off, output never exceeds the clamp, anti-windup plateaus the
    accumulator at the clamp and unwinds promptly, hold/clear se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
    [servo_decimator.v, servo_pi.v, tb_servo_decimator.py, tb_servo_pi.py, tb_util.py, test_hdl.py]
2026-08-26 Add flip FSM, error path, output mux, heartbeat -- all benched
    servo_flip_fsm.v implements the six-step flip with zero-window
    qualification over consecutive decimated samples, dead time on both
    sides of the polarity toggle, settle delay (eddy placeholder), and a
    TIMEOUT_HOLD state that never flips at nonzero current. Two spec
    refinements folded back into docs/design.md: int_hold applies only
    while the bridge is open (a frozen integrator would fight the
    ramp-down in RAMP_DOWN), and servo_enable 1->0 performs a graceful
    ramp-to-zero stop instead of dropping the bridge at current.
    servo_error.v (setpoint mux + polarity rotation + sign-mismatch flag),
    servo_output_mux.v (deadband handoff, struc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
    [servo_error.v, servo_flip_fsm.v, servo_heartbeat.v, servo_output_mux.v, tb_servo_error.py, tb_servo_flip_fsm.py, tb_servo_heartbeat.py]
2026-08-26 Integrate the servo into coil_servo_top and the real block design
    cores/coil_servo_top.v holds ALL inter-core wiring in synthesizable
    Verilog: CFG/STS slicing per docs/register_map.md, DIO 2FF sync +
    dio_invert + flip edge detect, error path, twin decimators, PI, output
    mux (gated by bridge_en), auto/manual boost, heartbeat. Submodules
    moved to modules/ (packaged with the core by scripts/core.tcl, the
    upstream hierarchical-IP pattern). The block design reduces to proven
    playground-shaped plumbing: hub (CFG 512 / STS 256), ADC, DAC, capture
    FIFO, XADC, one concat.
    E1 pins become named per-signal BD ports (bridge_polarity_o G17,
    bridge_enable_o H16, boost_o J18, flip_req_i K17, arm_i L14, fau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
    [coil_servo_top.v, ports.xdc, servo_decimator.v, servo_error.v, servo_flip_fsm.v, servo_heartbeat.v, servo_output_mux.v]
2026-08-26 Add HIL host tools: deploy, check, step, sweep over wired Ethernet
    host/board/coil_servo_server.py (stdlib-only, runs on the board's
    official OS 3.x) mmaps the axi_hub window and serves READ/WRIT/POPS
    over TCP; host/coil_servo_host is the lab-PC side: Board client with a
    CFG shadow so named field writes never clobber neighbors, channels.toml
    (every provisional value per channel, board addresses on the WIRED
    Ethernet network only), deploy (scp + fpgautil + server), check
    (heartbeat/LED/status sanity, never enables the servo), step
    (open-loop or closed-loop step -> CSV), sweep (swept-sine open-loop
    transfer function -> CSV, stimulus from a lab function generator on
    IN2, frequency auto-detected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
2026-08-27 Documentation review pass for the physicist audience
    Applied findings from a fresh-eyes review. Critical fix: the register
    map listed the XADC at 0x42000000 -- that is the capture FIFO, and
    reads there pop it destructively; XADC is at 0x44000000 (the code was
    always correct, the doc was not). Also: fixed the DIO6 heartbeat scope
    pin (E1 pin 15, not 7 -- pin 7 is the boost output) and added a full
    logical-DIO -> physical-E1-pin table with the pull-down behavior.
    Setup fixes: README Setup A now installs the repo packages
    (pip install -e .[dev]) so pytest actually works, and documents the
    libtinfo5-on-Ubuntu-24.04 workaround; pyproject pins python>=3.11 and
    cocotb>=2.0 (matching tomllib and co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
    [sweep.py, watch.py]
2026-08-27 Add ONBOARDING.md for new lab members
    First-hour setup, reading order, the layered verification chain and
    where to be suspicious, conventions for working with Claude in this
    repo, and the safety ground rules.
2026-08-27 Add board-only I/O test section to bringup
    Section 3b: verify every digital input/output with jumper wires from
    the E1 3V3 pins and a scope (including a full flip sequence, which
    completes immediately with nothing on IN1), and close a real feedback
    loop with a single OUT1->IN1 SMA cable -- the board becomes its own
    flat unity plant, validating DAC/ADC scaling, the closed loop, and the
    step/sweep toolchain before any power hardware exists. Notes the 2x
    hi-Z loopback factor, the 3.3V-only rule, and what board-only tests
    cannot show.
2026-08-27 README: WSL2 build path for a Windows laptop; Vitis made optional
    Setup B now notes that this repo Makefile only invokes vivado (the
    Vitis-dependent devicetree/FSBL targets were removed in the strip), so
    Vitis can be skipped on disk-constrained machines, and to select only
    Zynq-7000 device support. New B-alt subsection: full WSL2 walkthrough
    (install, libtinfo5, installer via WSLg, clone inside the Linux
    filesystem, memory limit fix), with the honest caveat that AMD does
    not officially support WSL.
2026-08-27 README: fix stale libtinfo5 .deb URL, add fallback instruction
    The 6.3-2ubuntu0.1 revision was superseded by 0.2 on the mirrors (hit
    as a live 404 during NUC setup); point at the current file and tell
    the reader how to find the next revision when this one goes stale too.
2026-08-27 README: real-world fixes from the first WSL Vivado install
    Lessons from installing on the lab NUC: the 2025.1 unified installer
    lays out /opt/Xilinx/2025.1/Vivado (not Vivado/2025.1) -- fixed both
    settings64.sh command lines; the installer file is named
    ..._Unified_SDI_...; and chmod fails on the Windows-mounted drive, so
    copy the installer into the Linux home before running it. Also note
    the bundled Vitis HLS cannot be deselected and is harmless.
2026-08-27 Add host-side safety rails: clamp guard, config validation, warnings
    Board now refuses out_clamp writes above the channel rated counts
    unless constructed with max_clamp=None (typo rail -- the fabric clamp
    remains the real enforcement); all tools pass the limit. step refuses
    --amps beyond rated. load_channel rejects configs that would silently
    defeat safety behavior: I_FS < I_rated (clamp unrepresentable), zero
    flip window, disabled flip timeout. step/sweep now print the loud
    fault and setpoint-sign-mismatch warnings design.md promised, via
    Board.warn_flags(). Two new tests; suite now 53 passed; docs updated.
    [board.py, check.py, config.py, step.py, sweep.py, test_config.py, test_protocol.py, watch.py]
2026-08-27 Deploy guard: refuse to reload the FPGA while the servo is active
    Reprogramming the FPGA drops all outputs instantly with no graceful
    stop -- at nonzero current that dumps the coil energy into the bridge
    body diodes. deploy now queries the existing register server first and
    aborts if the bridge is enabled or current is flowing; a silent board
    (fresh install) proceeds, and --force overrides for stale/foreign
    bitstreams whose status reads are garbage. Tested against the mock
    server (active, quiet, absent). Suite: 54 passed.
2026-08-27 Record the setpoint slew-rate limiter as a shelved option
    design.md section 4b: why it is not needed now (fast settling is the
    requirement; the boost cap exists for it), the physical reasons that
    would change the call (dB/dt impulse on mounts, chamber eddy heating),
    and where it would go if ever built (ramp generator in fabric at Node
    B, rate in CFG word 15 -- earmarked in the register map).
2026-08-27 channels.toml: first board's fixed IP on the mot channel
2026-08-27 Pipeline the drive-mux input to close timing at 125 MHz
    First hardware build failed timing by -1.98 ns: the CFG registers ->
    open-loop clamp comparison -> drive-source select -> output-mux
    compare/negate/saturate chain ran as one 19-level combinational cone
    into out2_reg (playground met timing, isolating it to our logic; the
    cone got this long when open_loop added sp_clamped in front of the
    mux). Register u_drive once before the mux: each half now has a full
    8 ns cycle. One extra cycle of drive latency against a 128-cycle PI
    tick; all 54 tests unchanged and green.
    [coil_servo_top.v]
2026-08-27 deploy: call fpgautil by its full PATH over non-interactive ssh
    Hit live on first deploy: ssh <cmd> skips the login profile that adds
    /opt/redpitaya/bin to PATH, so fpgautil came back command-not-found
    (exit 127) and the deploy aborted after the scp.
    [deploy.py]
2026-08-27 deploy: stop pkill from killing its own ssh shell
    pkill -f coil_servo_server.py matched the remote shell executing the
    deploy command itself (its command line contains the pattern), killing
    the session before the server could start -- ssh exit 255 on the first
    real deploy. Standard [s] bracket trick so the pattern matches only
    the actual server process.
2026-08-27 deploy: split server kill and start into separate ssh calls
    The [s] bracket trick failed because the same command line also
    carried the plain filename in the nohup part, so pkill still matched
    and killed its own shell. Structural fix: the kill runs in its own
    ssh call with any exit tolerated (it always drops its own connection
    after signalling the old server); the start runs in a clean second
    call.
    [deploy.py]
2026-08-27 Status: first hardware deploy successful
    Heartbeat counter advancing at exactly 125 MHz (6.49M ticks per ~52 ms
    poll), LED walk confirms register writes, power-on state is the safe
    IDLE (bridge open, outputs zero), measured-current offset ~1.3 mV as
    predicted. Builds on the lab NUC via WSL.
2026-08-27 Register server: one thread per client, request-atomic via a lock
    Found live: watch held the single served connection, so any other tool
    connected (TCP backlog) but was never serviced and timed out -- the
    tools were designed to run concurrently, the server wasn't. Thread per
    client with a lock keeping each request/response atomic against the
    shared memory map. Deploy guard now gives a clear message (or --force)
    when a present server doesn't answer instead of crashing. New
    concurrency test; suite 55 passed.
    [deploy.py, test_protocol.py]
2026-08-27 Lab notes: first hardware bring-up session (2026-08-27)
    Commissioning record of the first deploy: register link, 125 MHz clock
    confirmation via heartbeat counter, safe power-on state, watchdog
    cut-out test, clamp/anti-windup/mutual-exclusion observation, and the
    scoped flip sequence with dead time (safety invariant 4 on silicon).
    OneNote-pasteable HTML with placeholders for the scope screenshots.
2026-08-27 Lab notes: embed the two scope captures
    Screenshots (1 ms/div clamp/heartbeat view; 500 ns/div single-shot
    flip with dead time) embedded as data URIs so the page is a single
    self-contained file for OneNote paste and Google Docs import.
2026-08-27 Lab notes: fault input verified (new section 5)
    Pin 13 touch test done: fault flag follows the pin, report-only as
    designed. Removed from the remaining-items list.
2026-08-27 Lab notes: dio_invert verified (section 6); digital campaign complete
    All-software test with no wires: fault/arm inversions observed on
    their flags, flip-bit inversion edges triggered real flip sequences
    (polarity 0->1->0), register restored. Remaining list is now just the
    analog loopback and the monostable.
2026-08-27 Board: sync the CFG shadow from hardware at connect; loopback notes
    The shadow started as zeros, so a fresh connection's first write_cfg
    rewrote whole config words and cleared fields it never mentioned --
    observed live: write_cfg(open_loop=1) from a new REPL cleared
    servo_enable mid-measurement (a safe failure, but a real one). The
    client now reads the 16 CFG words back from the FPGA at connect;
    regression test added (56 passed).
    Lab notes gain section 7: first closed loop on hardware (i_meas
    regulating exactly onto the setpoint), the three-point raw calibration
    read = 2.03 x drive - 574 counts (true 2x hi-Z gain + ~-35 mV DAC
    offset, resolving the apparent 1.455 factor), the +-30 mA noise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
    [board.py, test_protocol.py]
2026-08-27 Loopback closed-loop step capture
    [step_loopback.csv]
2026-08-27 Lab notes: closed-loop step results (section 8)
    10-90% rise 102 us (~3.5 kHz closed-loop bandwidth), settled to 1% in
    259 us with no overshoot, tail on-target to 0.04% with 17 mA rms of
    DAC-hunting noise -- loopback worst case; a real coil filters it.
    Plot embedded; analysis of data/step_loopback.csv from the NUC.
2026-08-27 Loopback swept-sine TF
    [tf_loopback.csv]
2026-08-27 sweep: ignore noise-floor detections below --min-stim
    The tone detector happily locked onto ~60 Hz mains pickup (stim ~4 mA)
    on the undriven input during the first live sweep and logged garbage
    rows. Skip detections with stimulus amplitude below a threshold
    (default 0.05 A); the real drive was ~11 A.
    [sweep.py]
2026-08-27 Lab notes: swept-sine results (section 9) -- toolchain validated
    |H| = 2.024 flat to 0.3% over 100 Hz - 100 kHz, matching the DC
    calibration; phase fits a pure 139 ns differential delay (common
    pipeline latency cancels between stimulus and response). Bode plot
    embedded; every measurement tool now validated against known truth.
2026-08-28 Interface brief for the power-electronics discussion
    The servo as a black box: analog and digital interface requirements
    (scaling, polarities, fail-safe defaults, the heartbeat monostable),
    fabric-enforced guarantees, commissioned performance numbers, and the
    open questions the expert needs to answer (burden value, pass-bank
    transconductance, clamp characteristic, gate-driver logic, fault
    polarity, rails).
2026-08-28 Interface brief: keep the repo copy as Markdown
    GitHub renders .md and shows .html as raw source, so the repo copy of
    the power-electronics brief is now servo_interface_brief.md (same
    content); the HTML house-format version remains the deliverable sent
    to people directly.
2026-08-28 LICENSE: add the lab's copyright alongside upstream's
    Pavel Demin's MIT notice stays (required by the license for his build
    framework and cores, merged at tag 20251012); the coil-servo additions
    are (c) 2026 The Rb-Cs Lab (Ni group), Harvard University, same MIT
    terms. README gains a License section explaining the split.
2026-08-28 Operating scenarios playbook for sequence programmers
    Normal and off-nominal scenarios during ramping / experimental cycles,
    with what the board does in each, provisional timing budgets per channel,
    and the open unknowns that shape sequence design.
2026-08-28 Scenarios S3: correct auto-boost trigger description
    Auto boost arms at servo enable and post-flip re-enable (until 87.5% of
    setpoint), not on loop error magnitude; mid-run setpoint steps do not
    re-engage it.
2026-08-28 Future upgrades doc: ppm stability tiers and eddy pre-emphasis, shelved
    Records the discussed-but-not-scheduled upgrade paths (ppm-class current
    stability in two tiers, eddy-current feedforward / pickup-coil options,
    smaller shelved items) with costs, prerequisites, and limits; linked from
    design.md section 4b.
2026-08-31 Thermal: interlock thermal switches on expert agenda; soft-stop shelved
    Interface brief section 6 gains a thermal-protection item (CW dissipation
    numbers, thermal switches wanted in the interlock chain). Future upgrades
    gains the firmware supervisory temperature soft-stop with the revised
    decision wording and design sketch.
2026-08-31 Interface brief: capabilities-at-a-glance section (1b)
    Per-channel current ranges, ramp rates, reversal timing, loop dynamics,
    and stability in one table + bullets, provisional values flagged.
2026-08-31 System schematic diagram, linked from the interface brief
    Full circuit picture: rails + boost switch, pass bank, H-bridge with
    coil, active clamp, LEM sensing chain, gate drivers, interlock chain,
    heartbeat monostable, and every servo I/O with pin numbers.
2026-08-31 Schematic: draw the supply returns
    Hold supply and boost cap now connect to the return rail down the left
    side; omitted-for-clarity note updated.
2026-08-31 Schematic: move the LEM onto the coil conductor
    The sensor belongs on the coil side of the bridge (signed, coil-side
    measurement per the interface brief) - the previous placement on the
    return leg would read unsigned drive-frame current.
2026-08-31 Schematic: boost charger, body diodes, TVS backstop
    Details from the power-stage discussion: 15 V charger + charging
    resistor on the boost cap, H-bridge body diodes, and a TVS passive
    backstop in parallel with the active clamp.
2026-09-08 Interface brief: revisions from 2026-09-08 circuit-design review
    - OUT1/OUT2 stated as low-level commands (fixed +-1 V hardware range),
    never gate drives; pass bank expected to close its own local loop
    - New section 1c: per-channel L/R table (Kelvin pending, BLOCKING),
    two-rail rationale, boost-at-current 1.4 kW fault warning, full power
    arithmetic with the pass-bank figure corrected to ~200-240 W CW
    - L/I pairing clarified: 60 uH / 15 mOhm are the X/Y shims, not the
    100 A MOT channel (16 uH / 6.4 mOhm)
    - New section 2b + clamp_concept.svg: intended clamp topology for review
    - Burden buffer requirement made prominent in the IN1 row
    - Section 6 rewritten: every item states intent then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
2026-11-05 Refresh onboarding guide for current project state
    Commissioned-on-hardware status, power-stage design in progress, new
    docs in the reading list, lab setup section (NUC build machine, wired
    Ethernet, MOT board address, day-to-day tools), venv setup steps, 56
    tests, Rb-Cs-lab repo URL.
2026-11-10 MVP rewrite step 1: CLAUDE.md + mvp_architecture.md, archive BOOTSTRAP
    - docs/mvp_architecture.md: the power stage as built (Nov 2026) -
    topology, parts table, measured thresholds, pass-bank behaviour,
    H-bridge, safety logic board, sensing/scaling, power budget, open
    unknowns. Items where the analysis disagrees with the rewrite brief
    are flagged REVIEW (bridge freewheel vs TVS turn-down, clamp meaning,
    actuator resolution, loopback gain, ramp slack, monostable timing).
    - docs/mvp_rewrite_brief.md: the rewrite brief verbatim as the working
    plan for steps 2-6, with a header listing the disputed sections.
    - CLAUDE.md: plant, ports, invariants and open unknowns rewritten for
    the MV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
2026-11-10 MVP docs: measured monostable timeout 7.6 ms; TVS stated purpose
    From the Construction notes (2026-11-03): the 220 kOhm / 100 nF
    monostable drops in a consistent ~7.6 ms (HC123 on 3.3 V doesn't follow
    the 5 V datasheet timing). The MVP notes give the bank TVS a backflow
    protection role, which matches the freewheel analysis.
2026-11-10 Future upgrades: blocking diode + TVS across bridge input for fast turn-off
    Shelved option for the MVP: series Schottky at the supply + and a
    ~30 V TVS across the bridge input, with a firmware snap-off that opens
    the bridge at current: ~50 us from 100 A instead of the ~1.3 ms
    freewheel decay. Records why a bigger bank TVS or a varistor across the
    supply alone can't work, the ~160 V varistor hazard, costs, and the
    scope measurement that decides it.
2026-11-10 Future upgrades: lower op-amp gain plus fixed gate bias for finer drive
    Shelved until the as-built gain-8 stage has been characterized: why a
    resistor swap alone only gains ~1.6x, the gain + offset alternative
    (~5-7x finer OUT1 resolution and ground-noise immunity), and its
    constraints (bias below the hot threshold, low-noise reference).
2026-11-10 MVP system schematic, linked from mvp_architecture.md
    Full MOT-channel diagram as built: supply, H-bridge with body diodes,
    coils with LEM and varistors, low-side pass bank (ballast, gate
    resistors, TVS), OPA994 gain-8 stage, sensing chain, safety logic board,
    isolated gate drivers, Red Pitaya ports, control computer. Checked
    against the hardware by Santi.
2026-11-10 Decision: MVP turn-off keeps the bridge closed (freewheel)
    The firmware never opens the bridge at current; down-ramps and snap-offs
    go through the pass bank and the bridge freewheel path (~1.3 ms from
    100 A). Opening the bridge would dump coil energy into the SE-600-5
    output caps. The model defaults to freewheel physics, TVS behaviour
    behind a flag until the scope capture.
2026-11-10 MVP rewrite step 2: model the power stage as built
    - channels.py: MVP parameters (5 V rail, measured pass-bank V_th list,
    g_fs, ballast, gain-8 op-amp, OUT1 termination, LEM/burden/in-amp ->
    I_FS = 200 A, body-diode drop, TVS) with derived G_pass, dead zone,
    OUT1 command clamp, compliance limit and freewheel turn-off time.
    - plant.py: current-source pass bank with dead zone and per-FET sharing,
    5 V compliance on ramp-up, freewheel turn-down (TVS physics behind a
    flag), bridge-open fault branch; rejects any OUT2/boost command.
    - pi.py: FloatPI lower bound with anti-windup (MVP floor 0); output mux
    can disable OUT2. analysis.py: gains rescaled by the plant gain.
    - fullarch.py: lega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
2026-11-10 MVP rewrite step 3a: register map for the MVP firmware
    CFG widened to 32 words. New: ctrl b18 out2_enable, b19 trip_ack;
    W16 u_floor (RUN-only PI floor); W17-19 over-current trip level,
    persistence and timeout. STS b12 u_floor, b13 tripped; FSM states
    TRIP and TRIPPED; leaving IDLE needs an arm edge. Host Board shadows
    all 32 CFG words.
2026-11-10 MVP rewrite step 3b: fixed-point mirror with floor and out2_enable
    FixedPI gains a (switchable) lower bound with anti-windup and an
    integrator floor; output_mux_fixed honours out2_enable. Fixed-point
    tests now run on the MVP plant. Documents two model findings: large
    compliance-limited up-steps overshoot (ramp at <= 200 A/ms), and the
    gain-8 actuator dithers one OUT1 count (~0.12 A). Legacy full-arch
    plant/loop tests removed.
2026-11-10 MVP rewrite step 3c: HDL floor, OUT2 disable, arm edge, current trip
    servo_pi: lower bound input with anti-windup and integrator floor.
    servo_output_mux: out2_enable; outputs gated combinationally so both
    DACs are zero on the clock the bridge opens. servo_flip_fsm: arm edge
    required to leave IDLE; over-current trip (DACs off, freewheel with the
    bridge closed, open in the zero window or after a timeout, latched
    until trip_ack). coil_servo_top wires it all; CFG_DATA_WIDTH 1024.
    All cocotb benches now close the loop around the MVP plant, with a
    pin-level safety monitor in the integration bench.
2026-11-10 Docs: step 3 done, 100 A current trip decided, up-ramp rule
2026-11-10 Setpoint slew limiter in fabric: 200 A/ms up, 50 A/ms down
    Raw setpoint steps overshoot (up, compliance-limited) or undershoot
    (down, freewheel) on the MVP plant, so the firmware now enforces the
    ramp rules. servo_slew.v sits between the setpoint mux and the error
    path; CFG W15 slew_up / W20 slew_down (0 = setpoint frozen, fail-safe);
    FSM-forced zero and open loop bypass it. Bit-exact Python mirror
    (SlewLimiter, slew_rate_code); unit bench plus an integration test that
    steps 0 -> 70 -> 20 A with no overshoot or undershoot.
2026-11-10 Docs: ramp limits enforced in firmware; arm after servo_enable
    Bring-up recipe now says set servo_enable first, then raise arm (the
    2026-11 LED test sequence would stay in IDLE under the arm-edge rule).
2026-11-10 OUT1 sigma-delta dither for finer pass-bank drive
    The gain-8 op-amp stage makes one OUT1 count ~0.12 A, so a hold hunted
    ~50 mA p-p. servo_pi now outputs its 7-bit rounding residual;
    servo_dither.v runs a first-order sigma-delta every clock (+-1 count,
    clipped to [floor, clamp]) so the gate RC sees the PI output at 2^-7
    count resolution. CFG ctrl b20 dither_enable (reset off; open loop
    bypasses it). Bit-exact Python mirror (SigmaDelta) and unit bench; the
    integration bench, averaging OUT1 per clock, shows the 30 A hold go
    from ~50 mA hunting to within one ADC count. Hardware benefit
    (DAC linearity, op-amp at tens of MHz) still to be measured.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
2026-11-10 MVP rewrite step 4: host config and tools for the MVP
    channels.toml now holds the measurable physics (V_th, g_fs, op-amp gain,
    OUT1 termination, burden, in-amp gain, rail) plus trip, slew, dither and
    floor settings; config.py builds the model Channel from it and derives
    I_FS, the OUT1 clamp and the dead-zone floor (overridable by measured
    counts), refuses unsafe files, and prints a summary
    (python -m coil_servo_host.config mot). Tools: arm-edge prompt
    (Board.wait_for_run, disables on timeout), trip/floor flags, CFG
    readback in check, a deploy hint when no server answers, and open-loop
    step commands converted through the model (amps are not OUT1 counts in
    the MVP). STS word 0 bits 31:24 carry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
2026-11-10 deploy: post-load check that the board sits in its reset-off state
    After loading, deploy reads STS and fails unless the register-map
    revision matches, the FSM is IDLE, OUT1 command is 0, the bridge is
    disabled and arm is low (rewrite brief section 5).
2026-11-10 MVP rewrite step 5: documentation for the power stage as built
    Interface brief, operating scenarios and bring-up checklist rewritten
    for the MVP (5 V rail, gain-8 gate stage, freewheel turn-off, firmware
    trip/ramps/floor/dither, heartbeat latch, arm edge); README and
    ONBOARDING updated (status, safety rules, knob table, reboot/deploy
    gotcha); new lab_notes_2026-11.md; the dropped full-architecture
    features (active clamp, boost rail, source-sense loops, shunt-sense
    inner loop, hold capacitor, relay interlock chain, low-ripple supplies)
    moved to future_upgrades.md section 8; design.md gets an MVP-changes
    preamble; the old full-architecture schematic is removed.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
2026-11-10 Snap to zero: setpoint targets inside the zero window skip the slew limit
    Stepping the setpoint to zero ramped down at 50 A/ms (2 ms from 100 A),
    slower than the coil's 1.3 ms freewheel. The down-limit only prevents
    undershoot, which cannot happen at a zero target, so servo_slew takes
    any target with |target| < zero_win at once (small setpoints are kept,
    not zeroed). Bit-exact mirror and unit bench updated; the integration
    bench shows an 80 A snap-off freewheeling below the window in ~1.1 ms
    with the bridge closed.
2026-11-10 Model: bench-supply test profile (supply current limit, LEM turns)
    Channel gains I_supply_max (bench supply in constant-current mode; None =
    unchanged production behaviour), lem_turns (N primary turns through the
    LEM multiply the sensitivity: I_FS = lem_ratio / (R_burden G_inamp N)) and
    out_clamp_counts (clamp set directly instead of derived from I_rated).
    The plant caps the rising current at the supply limit; freewheel and
    bridge-open paths are unaffected.
    BENCH_CHANNELS["mot_bench"] (kept out of CHANNELS): MOT stage on a 5 V /
    3 A bench supply, rated 2.5 A, 10 LEM turns (I_FS 20 A), clamp 4000
    counts. test_bench.py covers the CC limit, gains/margins (incl. low
    near-threshold g_fs), closed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
2026-11-10 Host config: [mot_bench] low-current test profile
    channels.toml gains a [mot_bench] section: the MOT board and power stage
    on a bench supply (CV 5 V, CC 3 A), coil lead wound 10x through the LEM
    (I_FS 20 A, 2.44 mA/count). Rated 2.5 A, firmware trip 2.8 A (below the
    supply limit so it can fire), clamp set directly to 4000 counts (the
    derived one sits inside the dead-zone uncertainty), gains from
    suggest_gains on the bench plant, production ramp rates (physical rates
    are set by V/L), zero window 0.1 A. All PROVISIONAL where unmeasured.
    config.py: lem_turns and I_supply_max are physics keys; out_clamp_counts
    now flows into the model (model.clamp_counts == the register value);
    mot_bench gets t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
2026-11-10 step: --counts sets the open-loop OUT1 command directly
    For scanning the dead zone and G_pass when the model's amps-to-command
    estimate is not trusted (bench profile: the whole 0-3 A range spans ~26
    OUT1 counts just above an uncertain dead zone). Open loop only, bounded by
    the clamp. The request checks moved into setpoint_counts(), now tested.
2026-11-10 Integration bench: mot_bench register values through the HDL
    New coil_servo_top test closes the loop around the MOT plant on a 3 A
    current-limited supply with the registers the host derives from
    channels.toml [mot_bench] (I_FS 20 A, 10x slew codes, small gains, trip
    2.8 A, zero window 0.1 A): holds 2 A within one ADC count with the dither,
    then a 2.9 A setpoint trips before the supply limit, the bridge opens
    inside the zero window, and the FSM latches in TRIPPED. ~10 s of sim.
    World takes the plant channel and CFG builder as parameters.
2026-11-10 Docs: bench-supply test procedure (mot_bench)
    docs/bench_supply_test.md: step-by-step procedure for the first
    low-current campaign on a 5 V / 3 A bench supply -- jargon explained, what
    differs from production and why, wiring (supply in place of the
    SE-600-5, LEM wound 10x, in-amp gain as the alternative), supply
    settings, the measurement sequence (IN1 offset and turns check against
    the supply's ammeter, open-loop dead zone / gain scan with step --counts,
    closed-loop steps and dither, firmware trip at 2.8 A, freewheel scope
    capture, flips, heartbeat trip), what to write back into channels.toml,
    and what carries over to the 100 A build. Linked from bringup.md section
    5 and README "Start here".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
2026-11-11 Model: mot_bench as built -- one coil, one LEM pass
    The bench drives ONE coil of the pair (L ~9 uH = L_pair/2 + M, R 3.2 mOhm,
    both PROVISIONAL; at <= 3 A L only sets tens-of-us ramp/freewheel times)
    and the LEM stays on the 4/0 lead with one pass: lem_turns = 1, I_FS
    200 A, 24.4 mA per ADC count. Plant gain and suggested gains are back to
    the production values. Bench tests now use a +-1 ADC count band (0.1 % of
    2.5 A is a tenth of a count); hunting without dither is shown at 1.5 A,
    where the noise-free model produces it. lem_turns stays a parameter.
2026-11-11 Host config: [mot_bench] at the production sensor scale
    lem_turns = 1 (I_FS 200 A); gains back to kp 0.1044 / ki 3149; zero
    window back to 0.5 A (20 counts; IN1 offset ~0.29 A must be calibrated
    first). Trip 2.8 A = 115 counts, ~8 counts (0.19 A) below the 3 A supply
    limit: fires first unless the IN1 offset is more negative than about
    -0.15 A -- flagged in the file and printed by the summary. Clamp 4000
    marked pending user confirmation. Tests updated (slew codes, zero window,
    gains equal [mot]'s, trip margin).
2026-11-11 Model tests: bench loop at G_inamp = 1 and 10
    The optional in-amp gain of 10 (R_G jumper, one channels.toml line) is a
    supported bench variant: gains, margins, trip-below-supply, closed-loop
    steps (+-1 ADC count band), dithered hold and CC wind-up now run at both
    G_inamp = 1 and 10. New: the trip level sits >7 counts below the supply
    limit at both scales and the closed-loop rise over the 4-sample
    persistence is < 10 mA.
2026-11-11 Host: bench vs production made explicit; G_inamp a one-line switch
    * Gains may be written as kp_counts_per_amp / ki_counts_per_amp_ms (OUT1
    counts per amp of error), independent of I_FS; [mot_bench] uses them,
    so changing G_inamp (1 ships; 10 with an R_G ~1.1 kOhm jumper, comment
    block in the file) is the only edit -- trip, zero window, ramps, gains
    follow. Zero window 0.5 A suits both.
    * `bench = true` profile key (required together with I_supply_max). Every
    tool (deploy/check/watch/step/sweep/config) prints a banner for a bench
    profile naming the supply limit and "NEVER use with the SE-600-5".
    * CFG led byte: LED 7 lit with bench settings, 0 in production, written
    by apply_co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
2026-11-11 Docs: bench procedure for the setup as built; bench/100 A switching checklist
    One LEM pass, one coil (L ~8-10 uH PROVISIONAL), optional in-amp G = 10 as a one-line switch (jumpered R_G, remove before 100 A; forgetting it fails safe), 4000-count clamp and 2.9 A trip test as decided, IN1 offset sign vs the trip margin, LED 7 / banner / profile readback, and a two-column switching checklist linked from bringup.md and README.
2026-11-11 Model: bench clamp comment -- decided, no longer pending
2026-11-11 servo_slew: pipeline for timing (first MVP build failed by 2.2 ns)
    The one-clock limiter path from the IN2 ADC register through the source
    mux, the snap compare, a 29-bit subtract, compare and add into acc missed
    125 MHz by 2.2 ns. The target and snap test are now registered, and the
    limiting step alternates a measure phase (delta = target - acc) with a
    move phase (acc += 2*rate, or onto the target): same average rate, every
    path one adder or comparator deep. Python mirror and benches updated
    (bit-exact over 20k clocks); one extra clock of setpoint latency.
2026-11-11 Host tools: share capture decoding, unit conversion and step/sweep steps
    capture.py holds the FIFO decode and the decimated-record columns used by
    Board.capture, step and sweep; config.py gains i_meas_amps, counts_to_amps,
    out1_volts and summary_rows; step.py and sweep.py are split into
    prepare/capture/finish functions so the dashboard can run the same
    measurement logic. Board.sync_shadow() reloads the CFG shadow from the
    hardware for long-lived connections. Behaviour of the CLI tools unchanged.
2026-11-11 Timing: pipeline the PI floor logic, the FSM trip/window compares, the dither
    First MVP build: WNS -2.17 ns, 232 failing endpoints in slew_0 (fixed
    separately), pi_0 (-1.80 ns), fsm_0 (-1.03 ns), and two marginal paths.
    - servo_pi: saturated integrator sum registered in S_SUM; bounding,
    residual, windup and floor comparisons registered in a new S_PRE; the
    S_OUT update is a select. acc_lo built in two registered stages
    (overflow = any bit >= 47). A clear during a tick skips that tick's
    accumulation (clr_seen) so a precomputed sum never overwrites it.
    - servo_flip_fsm: |i| window/over-current compares registered one clock
    after the tick; holdoff/trip-count tests against precomputed l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
2026-11-11 SimBoard: a model-driven stand-in for a servo board
    Subclasses Board and replaces only the raw register protocol with an
    in-memory register file, so the CFG shadow, map-revision check, clamp guard
    and capture logic run as against hardware. Status reads advance a coarse
    wall-clock simulation (slew limits, compliance, freewheel, FSM incl. trip);
    a FIFO capture runs FixedPI against the MVP Plant tick by tick, including
    setpoint writes inside the window. Sim-only inputs: arm line, injected trip,
    and a stepped-frequency generator on IN2 for the sweep setup.
2026-11-11 Web dashboard: live monitoring for the LAN, control from the lab PC
    python -m coil_servo_host.dashboard serves an overview of every channel in
    channels.toml and a per-channel page (strip charts, flags, derived
    configuration, CFG read-back vs profile, waveform capture, step and
    swept-sine measurements). One background poller and one board connection
    per channel, shared by all viewers through server-sent events; monitoring
    only reads. Control actions are accepted only from an allowlist (default
    localhost), need confirmation when they can drive current, and are refused
    on an old register map. Status and action CSV logs per channel per day.
    Starlette + uvicorn (dashboard extra), plotting is a sm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
2026-11-11 Docs: dashboard and the bench profile (profile match, shared board, LED)
2026-11-11 servo_slew: choose the rate in the measure phase (second build: -15 ps)
    The move phase's path acc -> zero-detect -> rate select -> adder -> acc
    missed by 15 ps. The toward/away rate choice is now made and registered
    in phase 0 (acc cannot change between the phases); the move phase is an
    adder and a select. Python mirror latches the rate at the same point.
2026-11-11 Dashboard: one device per board, cards with a Test setup view, review fixes
    Implements the dashboard review (main @ aa2a92f1):
    - One device per board_host. mot and mot_bench are two profiles of the
    MOT board: one connection, one poll thread, one lock. The overview's
    cards come from host/config/dashboard.toml (MOT, Z shim, X shim,
    Y shim, Test setup); a card is a view of a board with one profile.
    The card whose profile the board holds is live, the other is greyed
    "board in use as ...", never red. The Test setup card is styled
    differently (BENCH badge, dashed purple border, supply limit).
    - Actions that drive current take the card's profile and are refused
    unless the board holds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
2026-11-11 Docs: dashboard cards, Test setup, look-only lock, one-hour logs
    docs/dashboard.md describes the cards (one board, two views), the Test
    setup styling, red vs amber vs grey, the stale display, the possible
    latch-trip guess and what the page cannot see, the enforced look-only
    lock, per-profile actions, the one-hour status log and capture pruning,
    and the new API fields. Test count 219 in README and ONBOARDING.
2026-11-11 Fix the latch-reset operating rule: stop the servo, not just disarm
    Disarming (DIO4 low) never stops a running servo -- losing arm mid-run
    does not drop the bridge, by design -- so the documented rule did not
    protect anything. The rule is now: servo_enable = 0, wait for IDLE
    (bridge open), then press the latch reset; re-enable and give a fresh
    arm edge to run again. bringup.md 3a rewritten with that order plus an
    arm-edge check (arm high before enable must not start the servo).
2026-11-11 Dashboard: latch reset rule is Stop first, not disarm
    Follows main's correction (5493db89): dropping arm never stops a running
    servo, so the rule before pressing the logic-board latch reset is STOP
    and wait for IDLE; to run again, Enable and a fresh arm edge. Fixed in
    docs/dashboard.md, the acknowledge panel, the FAULT LED note on every
    page and the amber possible-latch-trip text (which now points at STOP).
    Full pytest: 219 passed.
2026-11-11 Dashboard: default port 8081, print the address on the boards' network
    8080 is taken on the lab PCs by KoheronControl (the laser controller
    software), so the dashboard failed to start with a bind error. The
    default is now 8081, and a busy port gives a plain message instead of
    uvicorn's traceback.
    The start-up message guessed the LAN address from the host name, which
    picks the Wi-Fi address on a PC with Wi-Fi and Ethernet. It now prints
    the PC's own address on the route to the boards (no packet sent) and
    lists the others as "not on the boards' network".
    Full pytest: 220 passed.
2026-11-11 Lab notes: logic-board latch fault (CLK unwired) found and fixed
2026-11-11 Lab notes: logic-board acceptance test passed with the MVP firmware
2026-11-11 Host: leave open loop only from IDLE (integrator wind-up found on loopback)
    The loopback test tripped the board on the open -> closed loop switch:
    the firmware PI keeps integrating in open loop, so the wound-up value hit
    OUT1 the moment closed loop took over. Board.write_cfg now applies
    open_loop 1 -> 0 only from IDLE/TRIPPED (deferred when it comes with a
    stop, refused otherwise); new Board.stop() waits for IDLE, then leaves
    open loop and clears the integrator; step and sweep use it. Firmware fix
    queued in CLAUDE.md. Loopback results in the lab notes.
2026-11-11 Dashboard: STOP via Board.stop, leave open loop only once IDLE
    Follows a9f1a38d (Board.write_cfg defers/refuses open_loop 1 -> 0 while
    the servo runs: the firmware PI winds up in open loop). STOP and the job
    cleanup now call Board.stop(wait=False); the poll loop finishes the stop
    once IDLE (open_loop = 0, pulse int_clear), re-checking under the board
    lock that no enable came in between. The board client's refusal is shown
    as "press STOP and wait for IDLE first". Two tests; 223 passed.
2026-11-11 Dashboard: show the actual OUT1, label u14 as the PI command
    STS u14 is the PI output, not the DAC: with bridge_en low or out_kill
    (TRIP/TRIPPED) the firmware forces OUT1 to 0 while the held integrator
    keeps u14 nonzero, and in open loop OUT1 carries the clamped setpoint
    (coil_servo_top.v, servo_output_mux.v). The backend now computes the
    actual OUT1 (out1_actual: counts + mode off/open/closed, deadband
    applied); the header shows "OUT1 0 V (outputs off)" etc. with
    "PI command (u14)" beside it, the chart plots both, and the status log
    gets pi_volts and out1_counts columns. 224 passed.
2026-11-11 Register map rev 4: IN1/IN2 zero offsets, build ID, open-loop integrator clear
    - CFG W21/W22 in1_offset/in2_offset (s14 counts): subtracted, saturating,
    from every IN1/IN2 sample before the loop, the trip, the zero window, STS
    and the decimated capture (a magnetised LEM read -5.8 A at zero on 11-11).
    - STS W6 build_id: git commit (7 hex digits) + uncommitted-changes flag,
    stamped in by block_design.tcl; check/deploy print it.
    - PI integrator held cleared while open_loop = 1 (loopback wind-up, 11-11).
    - MAP_REV 4 (top, registers.py, mock server). Valid flag delayed one more
    clock for the new input register.
    - Host: in1_offset_amps/in2_offset_amps in channels.toml (bounded to 10 %
    of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
2026-11-11 Dashboard: firmware identity, zero offsets and zero calibration (map rev 4)
    - Every card and the card header show the firmware: register-map
    revision (red if not the host's) and build_id_text (commit, dirty flag).
    - Zero offsets panel: channels.toml value vs board read-back (amps and
    counts) with a mismatch flag; amber warnings "IN1 not calibrated"
    (in1_offset_amps = 0) and "board offsets differ from channels.toml".
    - Actions zero_cal / zero_store / zero_load (lab PC, confirmations,
    logged): zero.measure_offsets in a job, only in IDLE with bridge_en = 0,
    each record under the board lock so polling continues; loud warning
    above 0.3 A on IN1, refused above 10 % of full scale; store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
2026-11-11 Rev-4 bitstream deployed and checked on the MOT board
2026-11-11 Lab notes: Test 1 gate stage results (gain 7.94, OUT1 unterminated, op-amp ground fault fixed)
2026-11-11 Measured OUT1 calibration from Test 1 into model and config
    OUT1 terminated: 142.6 uV/count (1.168 V full scale), -41.3 mV at code 0;
    op-amp gain 7.93, gate ceiling 5.18 V. New channel fields out1_fs_volts,
    out1_offset_volts, V_opamp_max (channels.toml, all profiles). Derived MOT:
    dead zone 3385, floor 3047, clamp 4144; PI gains rescaled to kp 0.0900 /
    ki 2713. out1_volts() includes the offset; plant steady-state init uses it.
    One OUT1 count is now ~0.14 A, so the 50 A settling tests (model and HDL
    benches) run with the sigma-delta dither on, as on the board.
2026-11-11 Dashboard: measured OUT1 calibration rows; OUT1 off shows the DAC-code-0 voltage
2026-11-11 Test 2: sensor chain repaired, IN1/IN2 zero offsets measured
    REF floating (grounded only through decoupling caps) and an R_G solder
    bridge pinned the AD8421; 47k output resistor replaced with 49.9 ohm. The
    LEM is not magnetised -- the earlier -5.8 A was the wiring. Offsets
    IN1 +0.21 A / IN2 +0.15 A stored for mot and mot_bench.
2026-11-11 channels.toml: IN1 (LEM) zero offset removed for mot and mot_bench (LEM offset found to be 0 V)
2026-11-11 Tests: don't depend on the measured zero offsets stored in channels.toml
    Dashboard tests run the simulated boards on a copy of channels.toml with
    the IN1/IN2 offsets set to 0; the config and protocol tests patch or
    compare whatever value is stored.
2026-11-12 Test 3 day 1: measured IN1 scale, bench floor/clamp/gains, sign and ground fixes
    New Channel/config key in1_fs_volts (IN1 volts at full-scale ADC code; the
    firmware uses raw codes, the MOT board reads ~10 % low): 1.10 for [mot] and
    [mot_bench], I_FS 220 A. [mot] normalized gains rescaled to keep the same
    counts per amp. [mot_bench] from the open-loop scans: clamp 4100, floor 3450,
    starting gains kp 15.6 / ki 471 counts/A(/ms). Offsets re-measured. Tests
    derive expected values from the scale in use. Lab notes: LEM sign reversal,
    ground loops through earthed bench supplies, IN1 calibration, bank scan.
2026-11-12 Test 3 day 2: IN1 scale 1.12 V from a closed-loop 2 A hold, bench PI gains tuned
    - in1_fs_volts 1.10 -> 1.12 (board 1.988 A vs bench supply ammeter
    2.02-2.03 A); MOT normalized kp/ki rescaled to keep counts per amp.
    - mot_bench gains 31.2 counts/A, 942 counts/(A ms): 62.4/1884 oscillates
    at 21 kHz at a 1 A hold, so set at half (clean 1 A and 2 A steps).
    - Tests follow the new scale.
2026-11-12 Dashboard: software arm button for bench tests (dio_invert bit 1 pulse)
    After Enable, gives the FSM its arm edge from the page instead of DIO4, by
    pulsing dio_invert bit 1 (inverts the arm input ahead of the edge
    detector) and putting it back. Works with the deployed bitstream. The
    simulator now models dio_invert on the arm line.
2026-11-12 Test 3 day 2: trip, turn-off, flips, heartbeat trip, hold noise; bench limit 2.2 A, test coil 45 uH
    - Lab notes for 11-12: IN1 scale, gain tuning, firmware trip at 2.85 A,
    freewheel through the bridge body diode confirmed, flip dead time 1 us
    each side, heartbeat-latch trip (rail spike +2.5-3.2 V for ~10 us), and
    the open 10-20 kHz ringing of the bench power stage.
    - Bench I_rated 2.5 -> 2.2 A (ringing peaks came within samples of the
    2.79 A trip).
    - Bench coil is a temporary 12-turn test coil: L ~45 uH, R ~25 mOhm
    (calculated), replacing the 9 uH guess; bench tests updated.
    - bench_supply_test.md: latch reset after every deploy, corrected
    heartbeat-trip recovery (stop first), me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
2026-11-12 Benchtop test log covering Tests 1-3 (renamed from the Test 3 bench log)
    docs/benchtop_test_log.md now also has Test 1 (gate stage, with the
    gate sweep and power-loss plots), Test 2 (sensor chain faults and zero
    calibration) and Test 3 day 1 (sign, grounding, near-threshold scan);
    plots in docs/img/benchtop/. Links updated.
2026-11-12 Benchtop test log: add Test 0 (FET matching, logic board, first deploy, loopback, hand-driven bridge)
2026-11-12 Rev-5 bitstream (commit 275081b, timing met), deployed and tested on the bench
    coil_servo.bit.bin built on the lab laptop from 275081b (HDL = 704fd89):
    WNS +0.003 ns, WHS +0.042 ns, 0 failing. Rev-4 image archived as
    coil_servo_rev4_20261111.bit.bin. Deployed on the MOT board (mot_bench):
    2 A closed-loop pulse falls to 2 % in 0.14 ms with the zero-setpoint snap
    vs 1.55 ms without; small setpoints still held; IN2 path does not chatter.
    Re-zeroed offsets in channels.toml. Lab notes and CLAUDE.md updated.
2026-11-12 Rev 5 re-test after a power cycle; IN2 noise vs the snap threshold; re-zeroed offsets
2026-11-13 Benchtop log plots: no text on the data
    All benchtop plots redrawn with constrained layout and legends outside
    the axes (below the figure or beside each panel). Labels for reference
    lines (trip level, supply limit, zero window, op-amp rail) moved into
    the legend instead of sitting on the traces. Same data and processing.
    snap_sim.png (sim/plot_snap_traces.py) follows once the bench traces
    are regenerated.
2026-11-13 Benchtop log plots: legends inside the plot, never on data or other text
    sim/plotfit.py places each legend inside the axes at the first position
    whose box touches no data line, marker, error bar, filled area, shaded
    band or other text (adding headroom above the data if needed), re-places
    legends after layout shifts, and checks every finished figure for text
    that touches data or other text. All 27 benchtop plots regenerated with
    it (0 overlaps reported), including snap_sim.png from fresh bench traces.
2026-11-13 Capture decoder: setpoint column honours the bridge polarity
    The decimated capture records the drive-frame error (servo_error.v negates
    it at polarity 1) next to the board-frame current, so setpoint =
    measured + sign*error with sign -1 at polarity 1. decimated_columns() takes
    the STS polarity (default 0); step.py passes it. Found by the second
    session's slew test 3j (polarity-1 records showed 2*meas - sp).
2026-11-13 Board.write_cfg: per-word read-modify-write; capture decoder: undo the [21:6] floor bias
    write_cfg now re-reads each CFG word it is about to write, so a second
    connection's stale shadow can no longer put back servo_enable or the arm bit
    after another client stopped the servo (bench test 3l restarted a stopped
    servo that way). stop() re-reads word 0 before its open-loop check.
    decimated_columns adds +0.5 LSB to both columns: the captured [21:6] is a
    floor, biasing each by -I_FS/32768 (-6.8 mA at 224 A); bench test 3k holds
    then match the commanded setpoint within 0.3 mA.
2026-11-13 Benchtop log and lab notes: Test 3 day 3, pre-computer checks (stop/trip, arm, ramps, 50 shots, two clients, server restart)
2026-11-13 Interface brief: field-reversal rules measured on the bench (sign first, one flip pulse, hold arm, exact 0 V for the snap)
2026-11-13 Benchtop log: rewritten in plain language
    Every section's Why / How / Result, table headings and plot captions
    reworded so anyone in the lab can follow them without firmware jargon
    (controller instead of PI, steps instead of counts, built-in diodes
    instead of body-diode freewheel, ...). Same facts, numbers, plots and
    structure. New "Words used in this log" box explains the few names that
    remain (setpoint, OUT1/IN1/IN2, bridge, flip, arm, trip, safety board,
    the DIO pins).
2026-11-13 Lab notes and interface brief: rewritten in plain language
    Same facts, numbers, requirements, links and structure; wording only
    (checked: every number in the old text is still there). The lab notes
    gain a short "Words used in these notes" list; the interface brief keeps
    every requirement for the control computer exact (E1 pins, >= 1 us flip
    pulse, arm low-to-high after servo_enable, /10 divider and volts per amp,
    the bench rules: sign first, one flip pulse, hold arm, exactly 0 V).
2026-11-13 Interface brief: bench measurements in; lab notes and log: inconsistencies fixed
    Interface brief (design values kept, measured values added beside them):
    - IN1 full scale 224 A at 1.12 V (27.3 mA per step); offset calibrated
    and subtracted in firmware; IN2 scale still unmeasured (flagged).
    - OUT1: terminator fitted, 1.168 V full scale, -41.3 mV, gain 7.93,
    amplifier supply 5.18 V; bench turn-on at ~3540 steps.
    - New: a damper across the MOT pair is needed, and the current sensor
    must sit inside the coil-damper loop.
    - Zero snap acts on a zero setpoint only, not during flips or stops.
    - Safety board: reset only with the heartbeat present, reset after every
    firmware load, the firmware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
2026-11-13 Interface brief: zero snap during flips/stops is a limitation of build 275081b
    A firmware update (branch fw-snapflip) that makes the snap act during
    flips and stops is in testing, so the brief now calls the gap a known
    limitation of the deployed build rather than a permanent property, and
    "change the setpoint sign first" is recommended practice; one flip pulse
    per reversal, holding arm high and exactly 0 V for off stay requirements.
2026-11-13 Zero-setpoint snap also during the board's own forced zero (flip and stop ramp-downs)
    snap_enable now also holds OUT1 at 0 (integrator cleared) while the FSM
    brings the setpoint to zero itself -- ramp-down, dead time, settle, timeout
    hold -- with the bridge closed and no trip, so flips and stops run at the
    freewheel rate whatever the requested setpoint is. Bench test 3e found a
    ~0.4 A plateau of 150-250 us there with build 275081b. Register layout
    unchanged (map rev 5). New integration test: flip and stop with the snap off
    and on, bench and MOT models (bench 2 A flip: current to 2 % in 105 us vs
    176 us; MOT identical, the controller is already fast there).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
2026-11-13 scripts/lab-timing.sh: print the worst setup paths after a laptop build
2026-11-13 servo_dither: form the three clipped candidates in parallel (timing)
    The snap-in-flip build failed timing by 50 ps on dith_0 acc -> u_out (13
    logic levels: sigma-delta adder, 15-bit adder and both clip comparators in
    series). Now u14-1 / u14 / u14+1 are clipped in parallel with the
    sigma-delta step and up/down only select. Same function on every clock;
    the bit-exact dither bench is unchanged and passes.
2026-11-13 Interface brief: proposed damper sizing for the MOT pair
    Section 1c: how to size the resistor and capacitor (near critical
    damping, R ~ 2*sqrt(L/C), close to the coil impedance at the ringing
    frequency), values for 16 uH (proposed 22 uF + ~1.6 ohm; 10 uF + 2-2.5 ohm
    as the alternative), ratings for a bridge opening at 100 A (5-10 W
    pulse-rated non-inductive resistor, >= 50 V film capacitor, short leads),
    the Test 4 checks, and a note on metal near the coils. Open question 12
    points to it.
2026-11-13 Lab notes: proposed damper sizing for the MOT pair
    After the 11-12 damper test: how to choose R and C (near critical
    frequency), values for 16 uH (proposed 22 uF + ~1.6 ohm), ratings for a
    bridge opening at 100 A, the Test 4 checks, metal near the coils, and the
    11-13 follow-up on the 72 kHz / 290 kHz tones. Same content as the
    interface brief, section 1c.
    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
2026-11-13 Firmware 583e877: zero snap also in flips and stops, deployed and tested; zero-current noise reference
    Bitstream built on the lab laptop from 583e877 (fw-snapflip merged):
    WNS +0.251 ns, WHS +0.007 ns, 0 failing; the first build of the change
    failed by 50 ps in the dither, which now forms its candidates in parallel.
    Previous image archived as coil_servo_rev5_20261112.bit.bin.
    Bench (2 A, damper, LEM inside the loop): every reversal ordering and every
    stop reaches zero in ~140 us with the snap (before up to 380 us), 24/24
    reversals and 6/6 stops OK. Noise reference: most tones are measurement;
    the 200-400 kHz lines that grow with load current are pickup, not current.
    Log, lab notes, interface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
2026-11-13 Lab notes: point the damper follow-up to the zero-current reference
    The quick 11-13 estimate (290 kHz lines the same with and without
    current) is refined by the clean measurement added in 1cca3a1f: they grow
    with load current but are not coil current.
2026-11-13 Bench: fastest full reversal +-2 A, 0.81 ms to within 2 % (0.95 ms with current settings)
2026-11-13 Op-amp gate-stage rail raised to 12.01 V (was 5.18 V): V_opamp_max in config, model and dashboard
    Datasheet transconductance (73 S typ, 55 S min at 60 A) puts 100 A at
    about 5.0-5.3 V on the gates, at or above the old 5.18 V ceiling. The
    OPA994 runs on 2.7-32 V; the gates are rated +-20 V. The OUT1 clamp and
    the firmware trip remain the limits. Dashboard shows the ceiling to
    two decimals.
2026-11-13 Bench log + lab notes: Test 3 day 4, bench characterization (Q1-Q8)
    Stability margins, 45-min hold with Allan deviation, idle zero drift,
    1000 shots, pass-transistor scans cold/warm (12 V gate rail), trip noise
    margin and timing (switch-off spikes on IN1, rejected by trip_ticks 4),
    offline bank model, MOT damper and 5 A surge simulations. Damper energy
    estimate in the MOT damper proposal revised.
2026-11-13 CLAUDE.md: day-4 characterization facts (op-amp rail 12.01 V, trip_ticks >= 4, warm re-zero, surge explanation, MOT starting gains, damper energy)
